Bunty9/ssr4/docs/images/ssr4-bottom-web.jpg

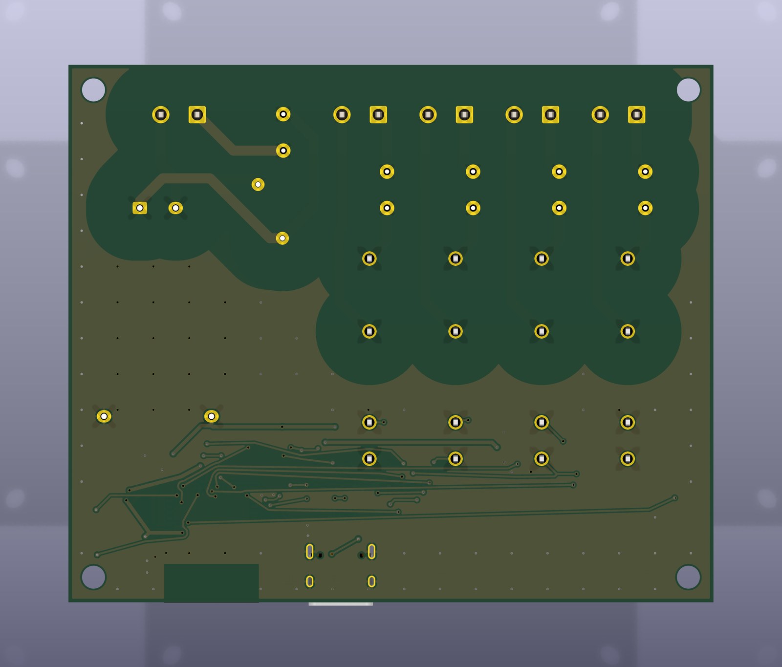
docs/images/ssr4-bottom-web.jpg
