Bunty9/ssr4/docs/images/ssr4-low-angle-web.jpg

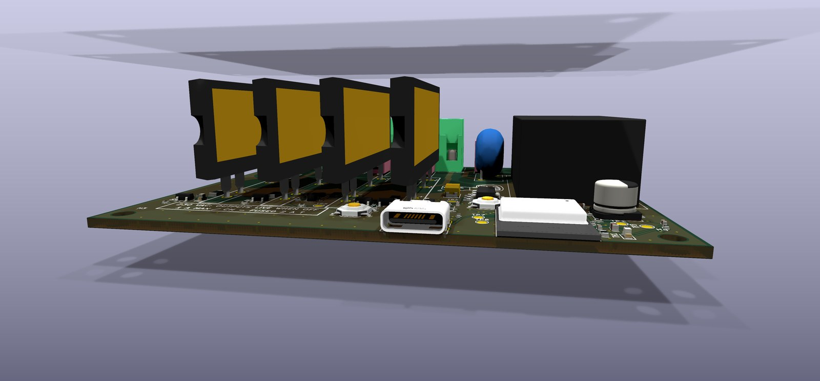
docs/images/ssr4-low-angle-web.jpg
