Bunty9/ssr4/hardware/fabrication/jlcpcb/bom.csv

Comment | Designator | Footprint | LCSC Part #
220u | C1 | CP_Elec_6.3x5.4 | C2977551
10u | C2,C4 | C_0603_1608Metric | C96446
22u | C3 | CP_EIA-3528-21_Kemet-B | C122226
100n | C5,C7,C8 | C_0402_1005Metric | C1525
1u | C6 | C_0402_1005Metric | C52923
D_Schottky | D1 | D_SOD-123 | C8598
LED | D3,D4,D5,D6,D7 | LED_0603_1608Metric | C2986060
Fuse | F1 | Fuse_Littelfuse_395Series | C99566
Fuse | F2,F3,F4,F5 | Fuse_Littelfuse_395Series | C142678
USB_C_Receptacle_USB2.0_16P | J1 | USB_C_Receptacle_HRO_TYPE-C-31-M-12 | C165948
CPC40055ST | K1,K2,K3,K4 | SIP-4_L38.1-W3.8_CPC40055ST | C1527353
HLK-PM01 | PS1 | Converter_ACDC_Hi-Link_HLK-PMxx | C209903
AO3400A | Q1,Q2,Q3,Q4,Q5 | SOT-23 | C20917
10k | R1,R2,R3,R4,R9,R11 | R_0402_1005Metric | C25744
22 | R5,R6 | R_0402_1005Metric | C25092
5.1k | R7,R8 | R_0402_1005Metric | C25905
220 | R10 | R_0402_1005Metric | C25091
2k | R12,R14,R15,R17,R18,R20,R21,R23,R24 | R_0402_1005Metric | C4109
220 | R13,R16,R19,R22 | R_1206_3216Metric | C17957
Varistor | RV1 | RV_Disc_D12mm_W6.7mm_P7.5mm | C2839517
SW_Push | SW1,SW2 | SW_Push_1P1T_XKB_TS-1187A | C318884
10k | TH1 | R_0603_1608Metric | C279936
ESP32-C3-MINI-1-H4X | U1 | WIFIM-SMD_ESP32-C3-MINI-1 | C41349510
AMS1117-3.3 | U2 | SOT-223-3_TabPin2 | C6186
USBLC6-2SC6 | U3 | SOT-23-6 | C7519
TMP302ADRLR | U7 | SOT-563_TI_DRL0006A | C2877557
Screw_Terminal_01x02 | X1,X2,X3,X4,X5 | TerminalBlock_CUI_TB007-508-02_1x02_P5.08mm_Horizontal | C8465
