Bunty9/ssr4/hardware/mechanical/ssr4-assembly.step

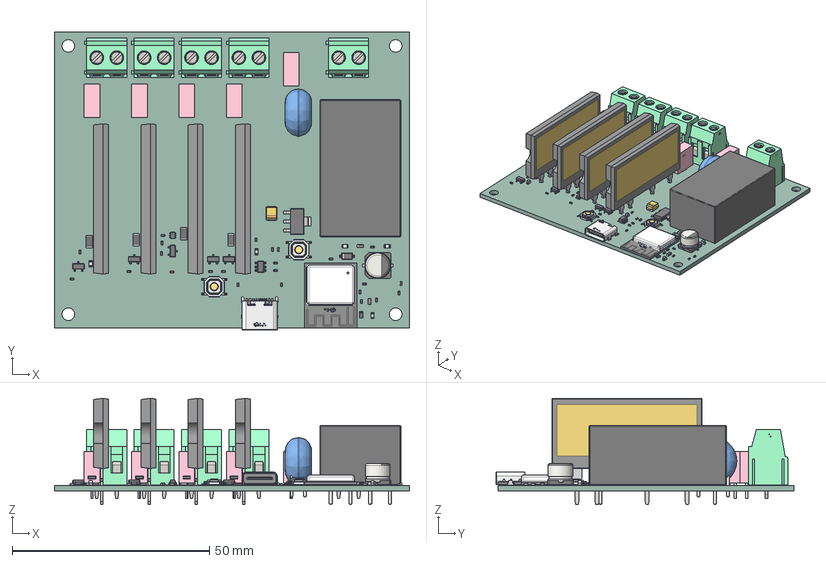
[picture p8: CAD file, 2026-10-29]
hardware/mechanical/ssr4-assembly.step
90.0 x 75.5 x 26.9 mm
FUSE-TH_L8.5-W4.0-H8.5-P5.08 x 5
D_SOD-123
SW-SMD_4P-L5.1-W5.1-P3.70-LS6.5-TL_H1.5 x 2
LED_0603_1608Metric x 5
CP_Elec_63x54
SOT-223
CONN-TH_2P-P5.00_WJ500V-5.08-2P x 5
R_1206_3216Metric x 4
R_0402_1005Metric x 20
WIFIM-SMD_ESP32-C3-MINI-1
SIP-4_L38.1-W3.8_CPC40055ST x 4
C_0402_1005Metric x 4
R_0603_1608Metric
SOT-23 x 5
C_0603_1608Metric x 2
SOT-23-6
CP_EIA_3528_21_Kemet_B
RV_Disc_D12mm_W67mm_P75mm
SOT_563
Converter_ACDC_Hi-Link_HLK-PMxx
USB-C_SMD-TYPE-C-31-M-12
circuit_PCB
