Bunty9/ssr4/hardware/mechanical/ssr4-outline.dxf

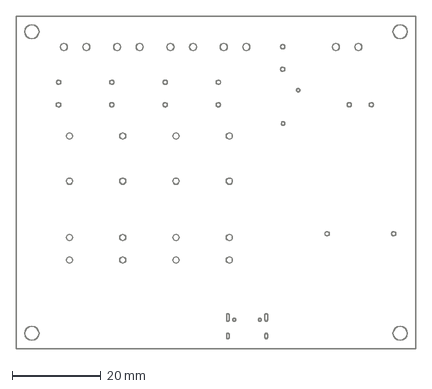
[picture p9: CAD file, 2026-10-29]
hardware/mechanical/ssr4-outline.dxf
90.0 x 75.0 mm
