Bunty9/ssr4/hardware/mechanical/ssr4-board-only.step

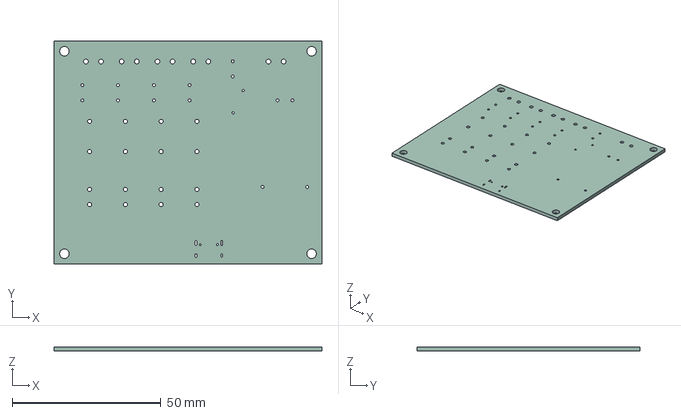
[picture p10: CAD file, 2026-10-29]
hardware/mechanical/ssr4-board-only.step
90.0 x 75.0 x 1.51 mm
