Bunty9/ssr4/validation/ntc-table.md

<!-- generated by `pcb publish` from blocks/calc.py -->
| Board temperature (°C) | NTC (kΩ) | IO0 voltage (V) | Slope (mV/°C) | ±35 mV ADC error as °C |
|---:|---:|---:|---:|---:|
| -20 | 105.38 | 3.014 | -16.1 | ±2.2 |
| 0 | 33.62 | 2.543 | -30.9 | ±1.1 |
| 1.4 | 31.23 | 2.500 | -31.8 | ±1.1 |
| 25 | 10.00 | 1.650 | -36.7 | ±1.0 |
| 45 | 4.35 | 1.000 | -27.2 | ±1.3 |
| 50 | 3.59 | 0.871 | -24.3 | ±1.4 |
| 55 | 2.98 | 0.757 | -21.4 | ±1.6 |
| 60 | 2.49 | 0.657 | -18.7 | ±1.9 |
| 80 | 1.27 | 0.372 | -10.5 | ±3.3 |
| 110 | 0.53 | 0.166 | -4.2 | ±8.3 |
