Bunty9/ssr4/hardware/ssr4-schematic.pdf

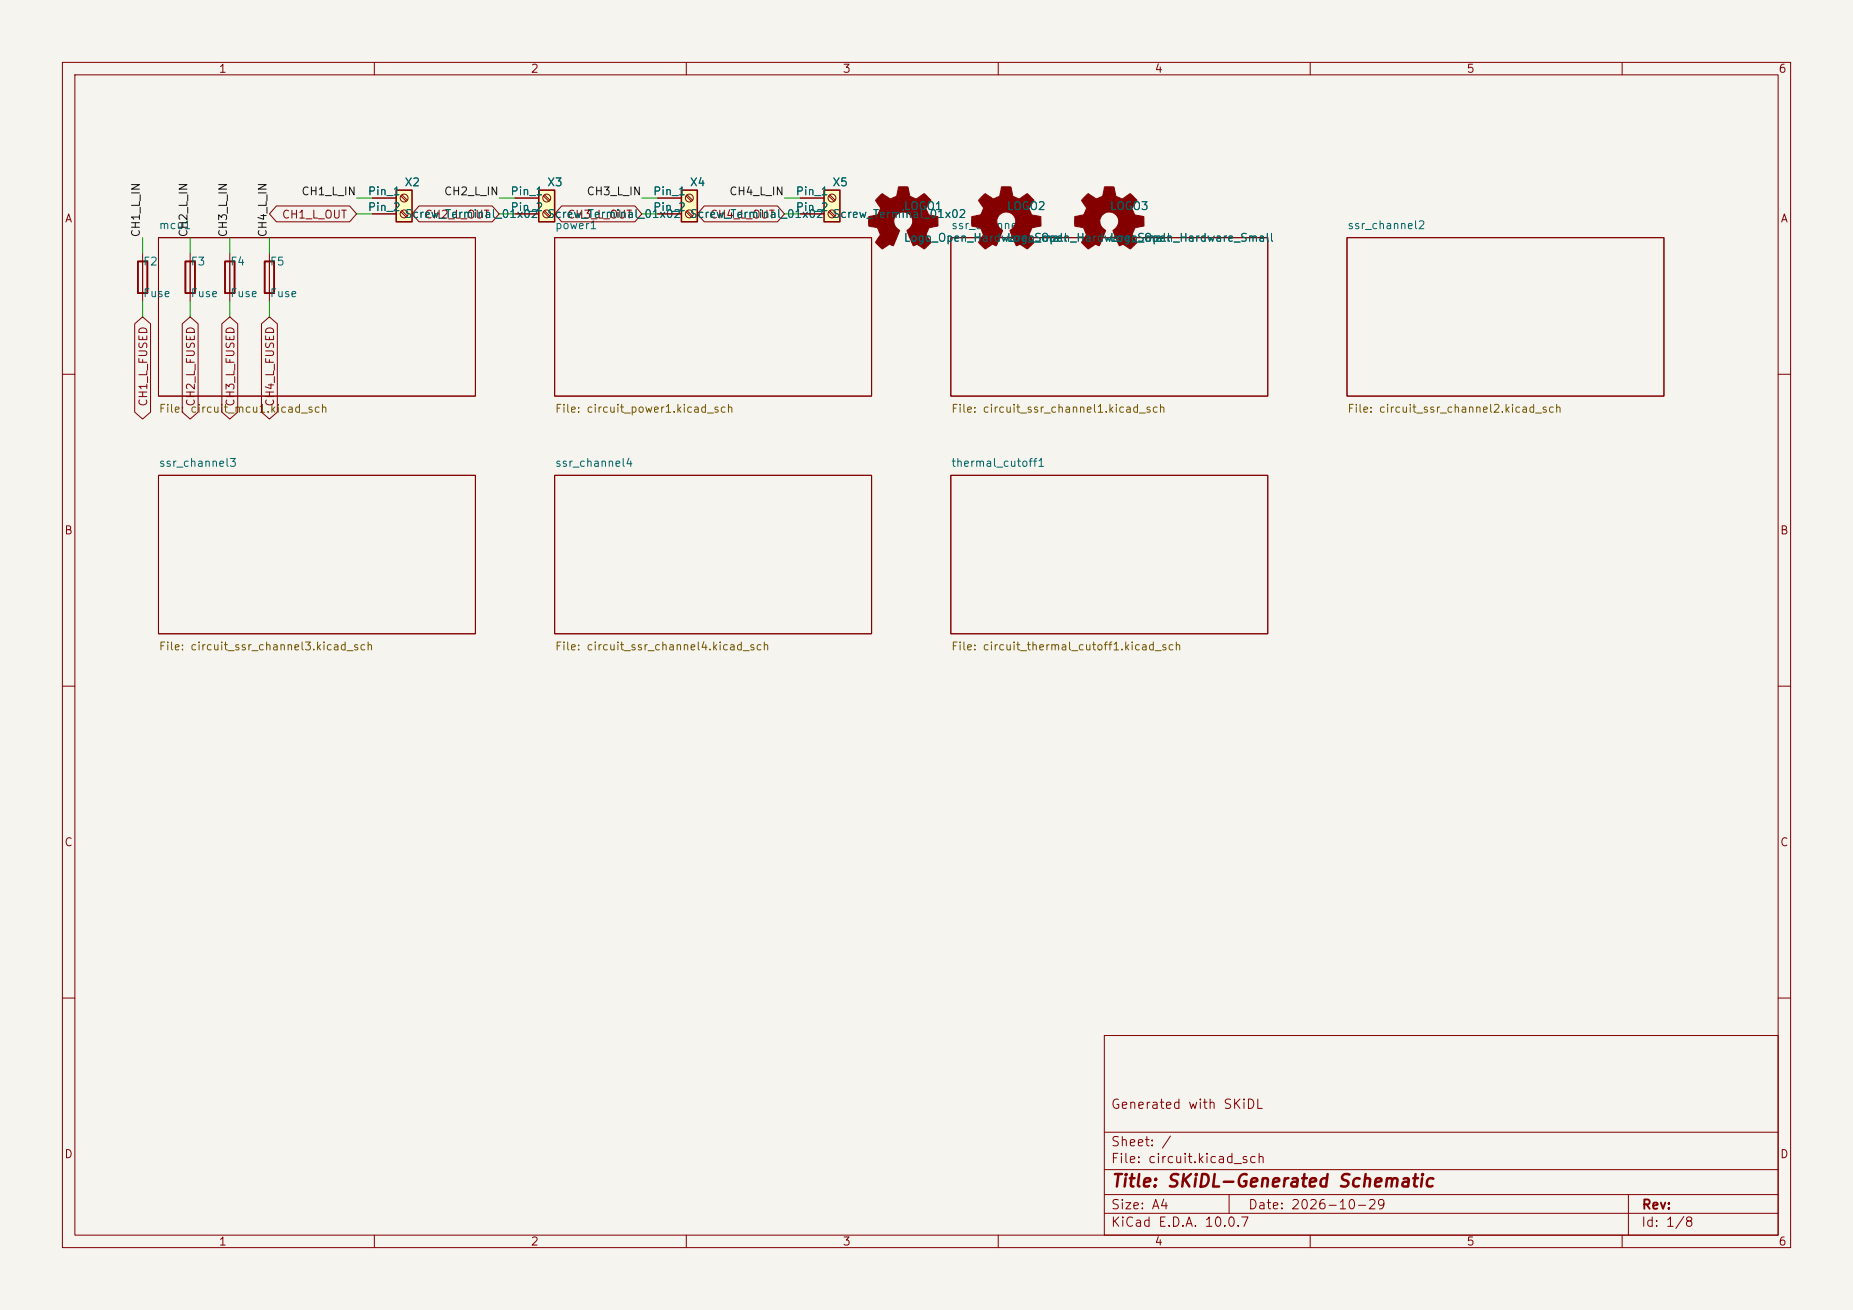
[picture p11: page 1]

Sheet: /
File: circuit.kicad_sch
Title: SKiDL-Generated Schematic

Size: A4 | Rev:
KiCad E.D.A. 10.0.7 | Id: 1/8

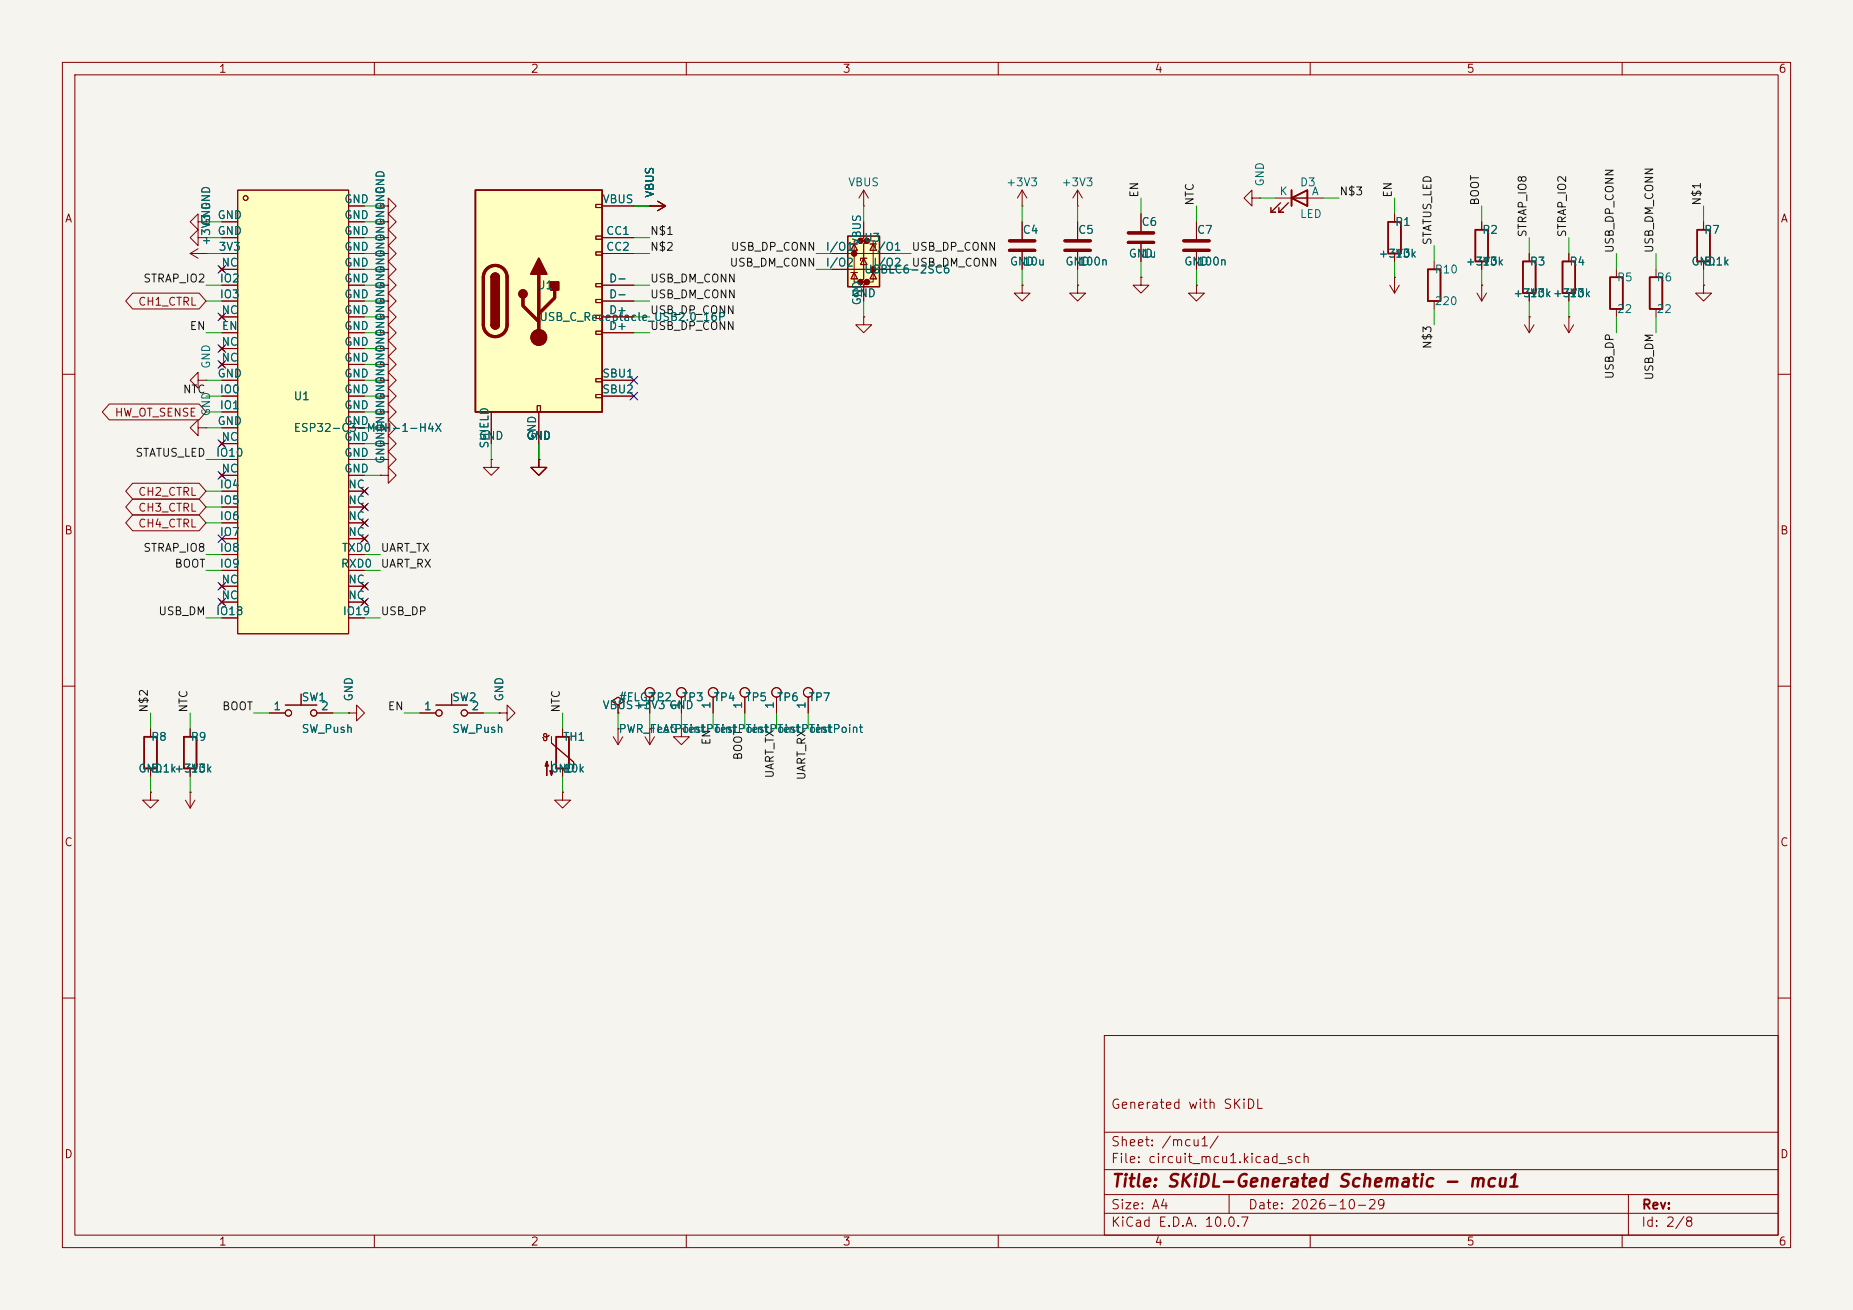
[picture p12: page 2]

NCNC
Generated with SKiDL GND GND

Sheet: /mcu1/
File: circuit_mcu1.kicad_sch
Title: SKiDL-Generated Schematic - mcu1

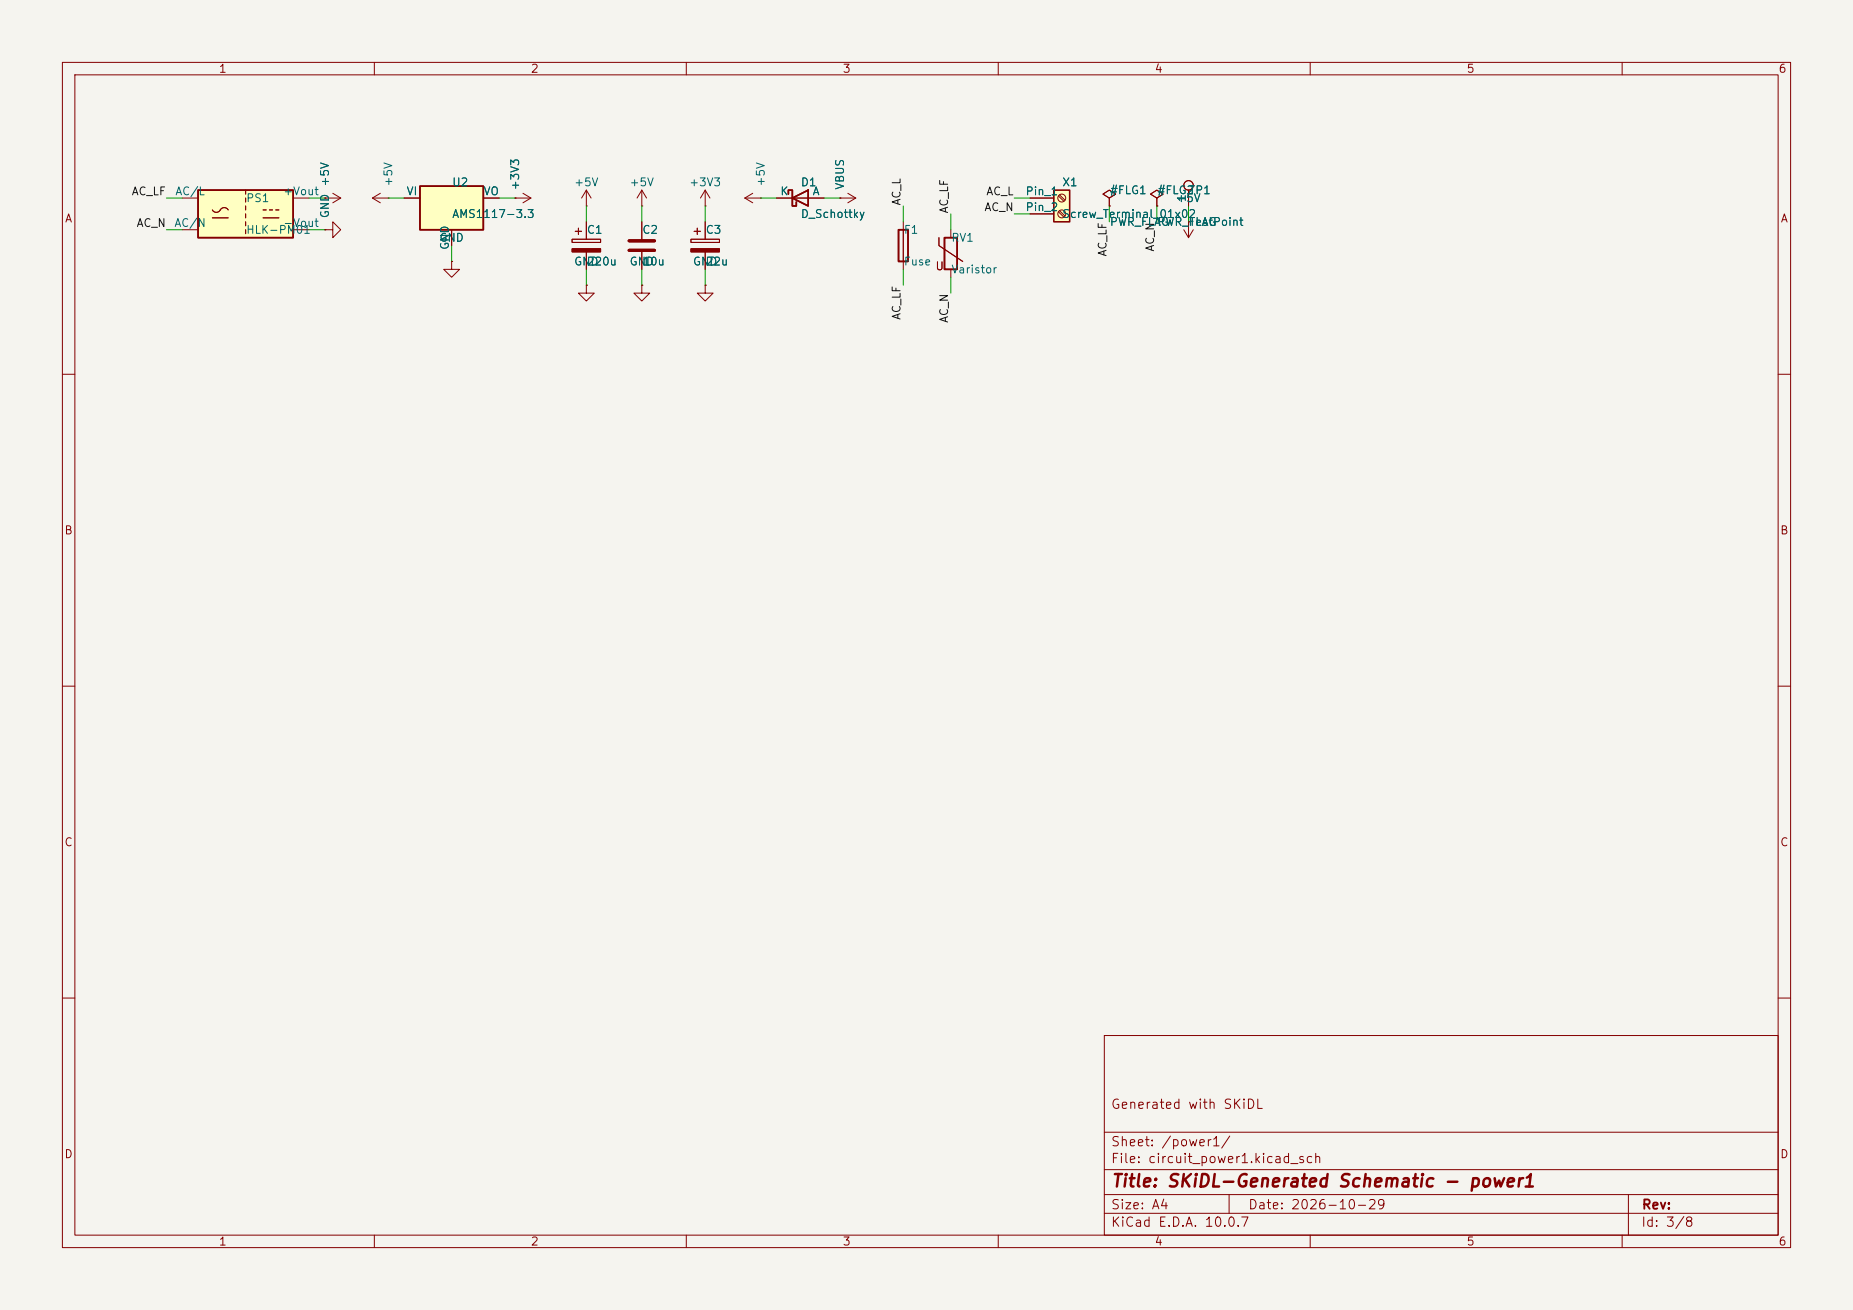
[picture p13: page 3]

Sheet: /power1/
File: circuit_power1.kicad_sch
Title: SKiDL-Generated Schematic - power1

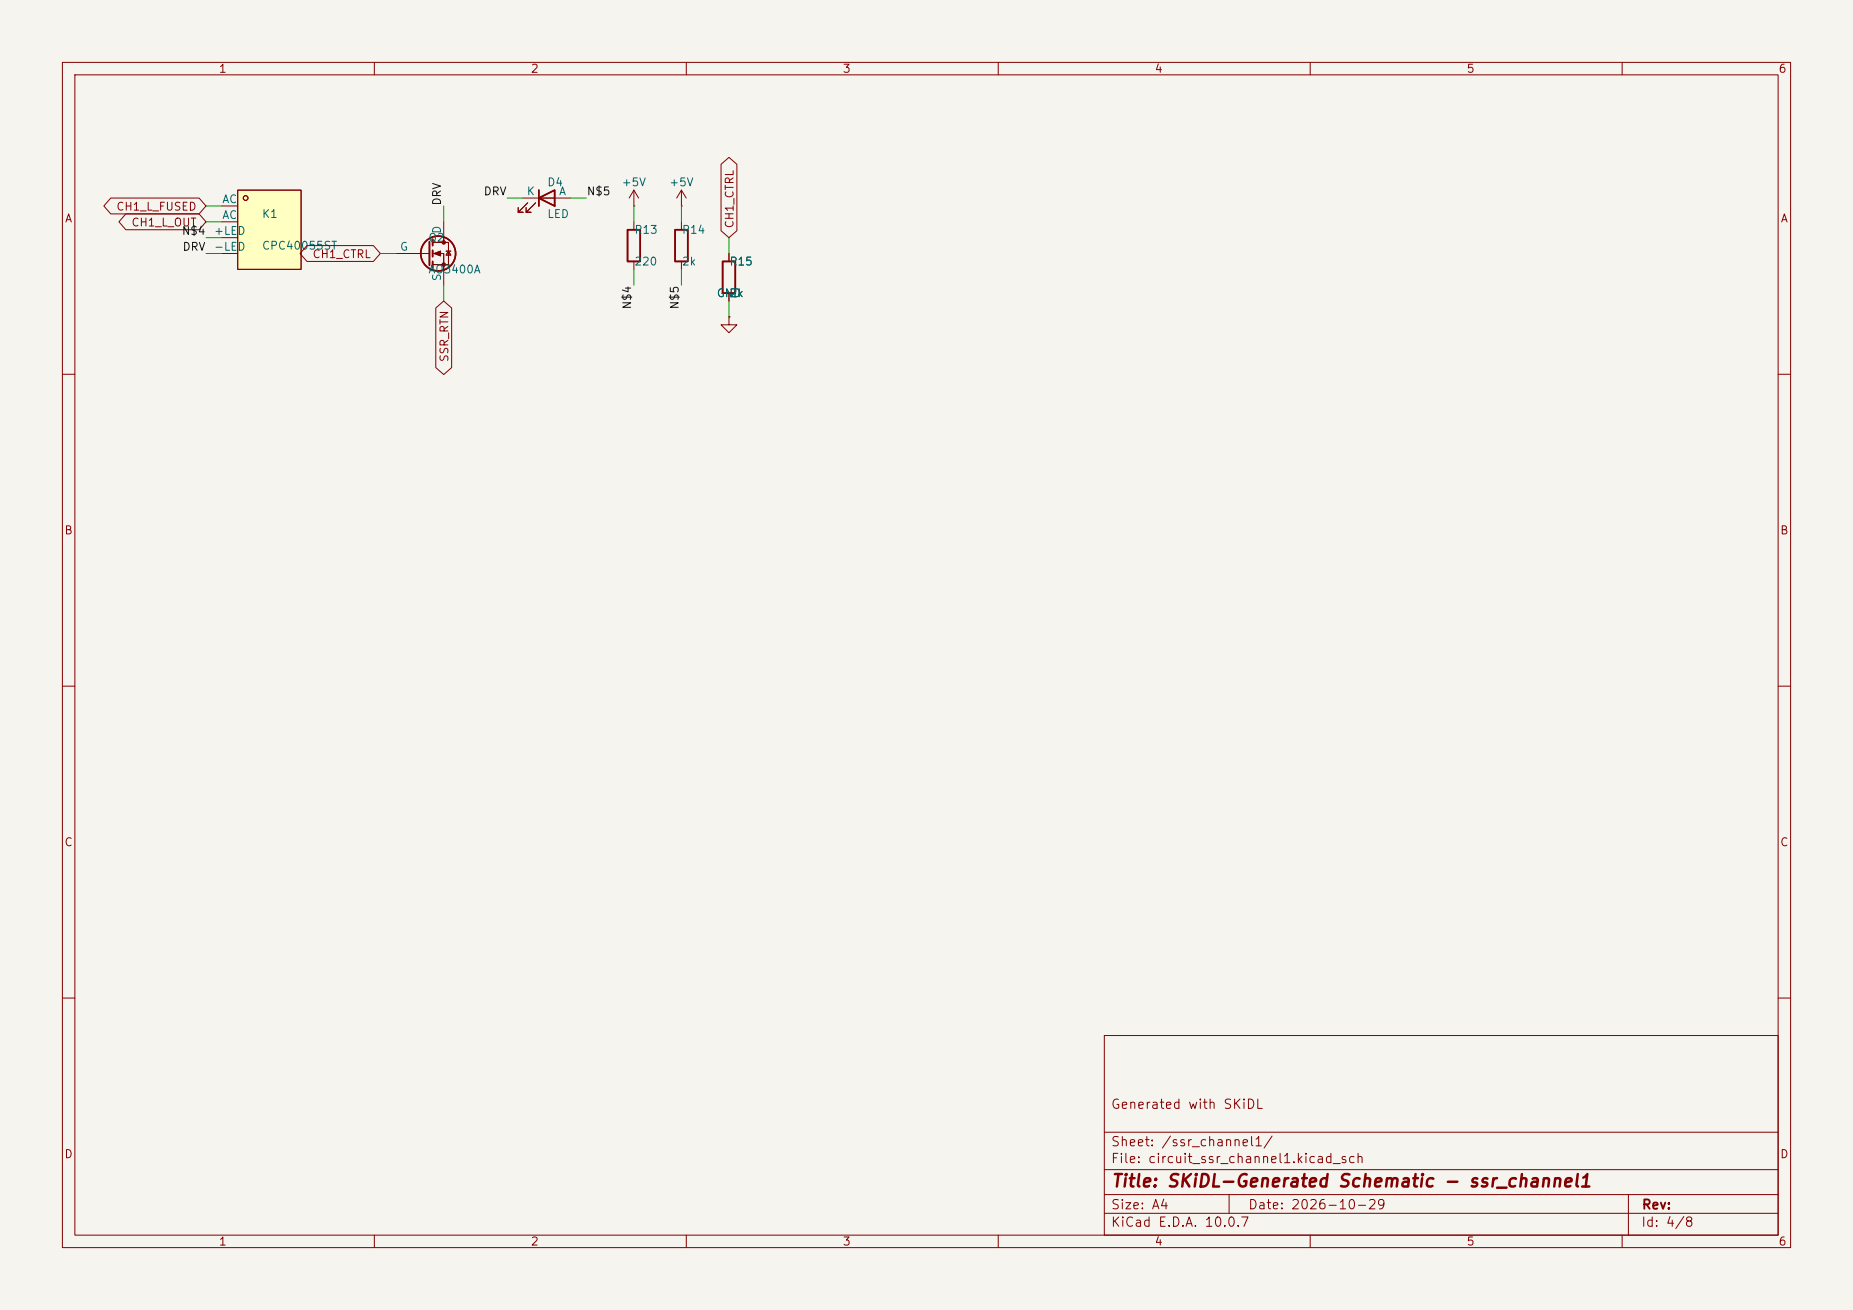
[picture p14: page 4]

Sheet: /ssr_channel1/
File: circuit_ssr_channel1.kicad_sch
Title: SKiDL-Generated Schematic - ssr_channel1

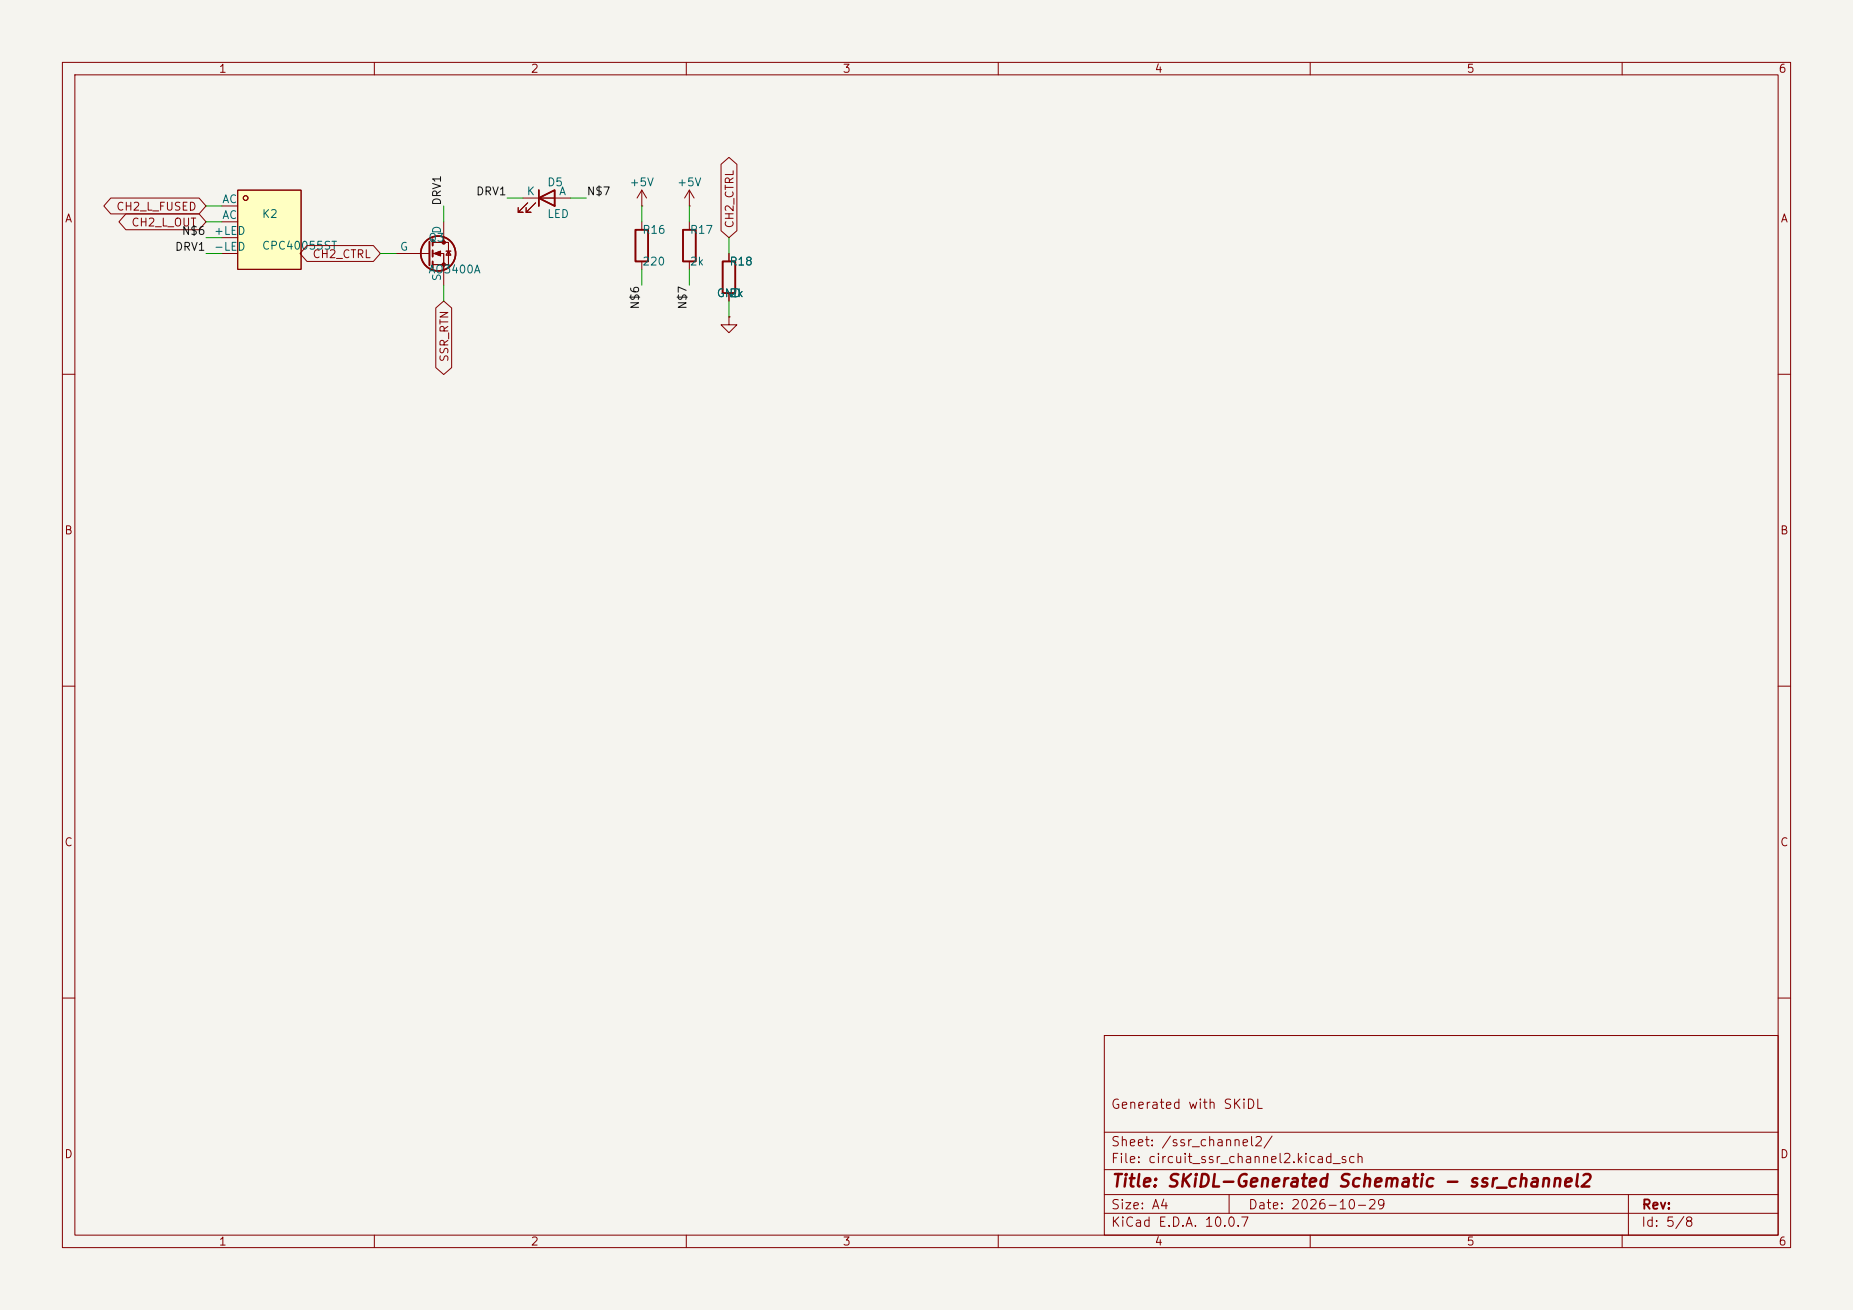
[picture p15: page 5]

Sheet: /ssr_channel2/
File: circuit_ssr_channel2.kicad_sch
Title: SKiDL-Generated Schematic - ssr_channel2

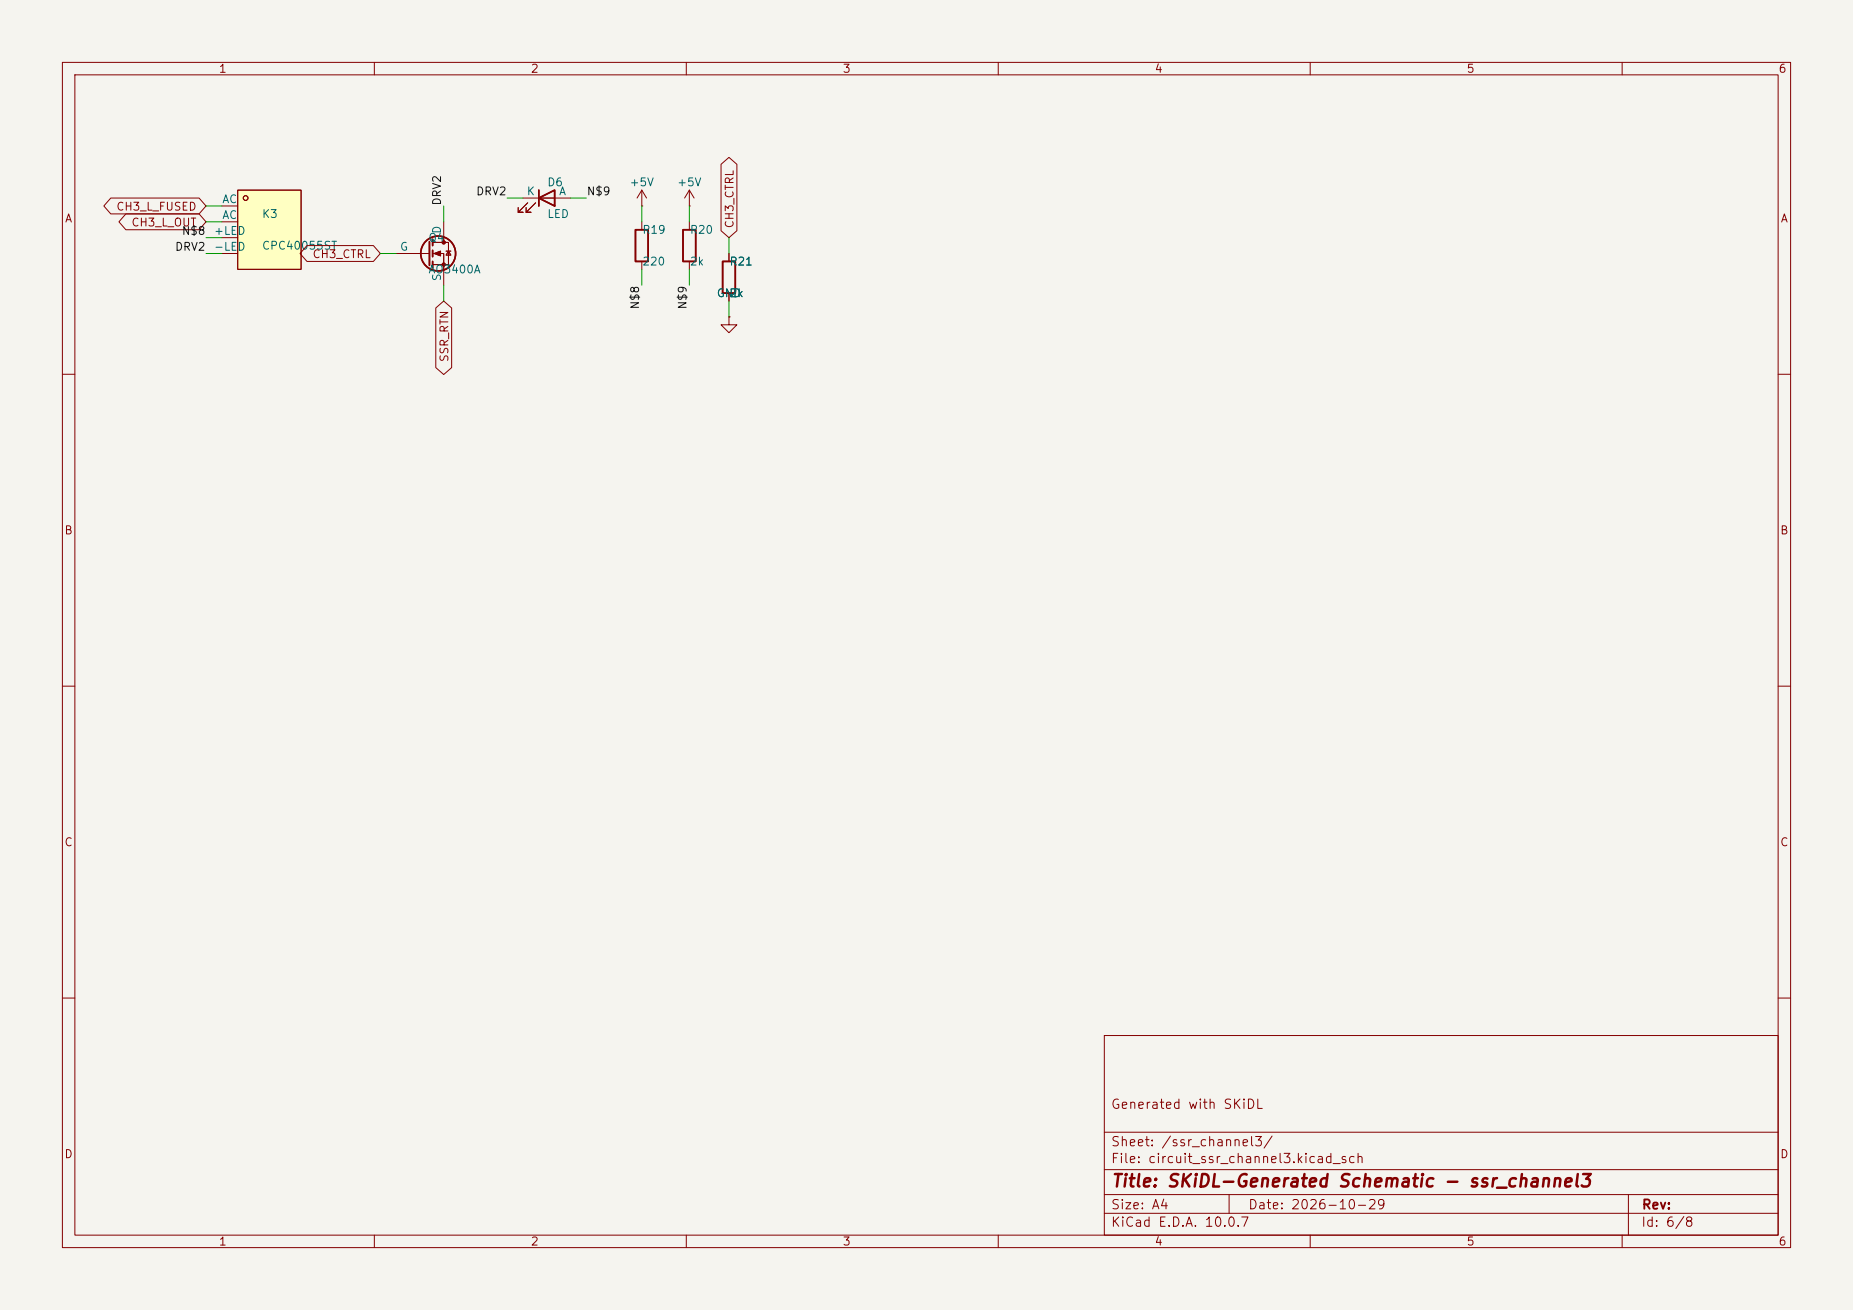
[picture p16: page 6]

Sheet: /ssr_channel3/
File: circuit_ssr_channel3.kicad_sch
Title: SKiDL-Generated Schematic - ssr_channel3

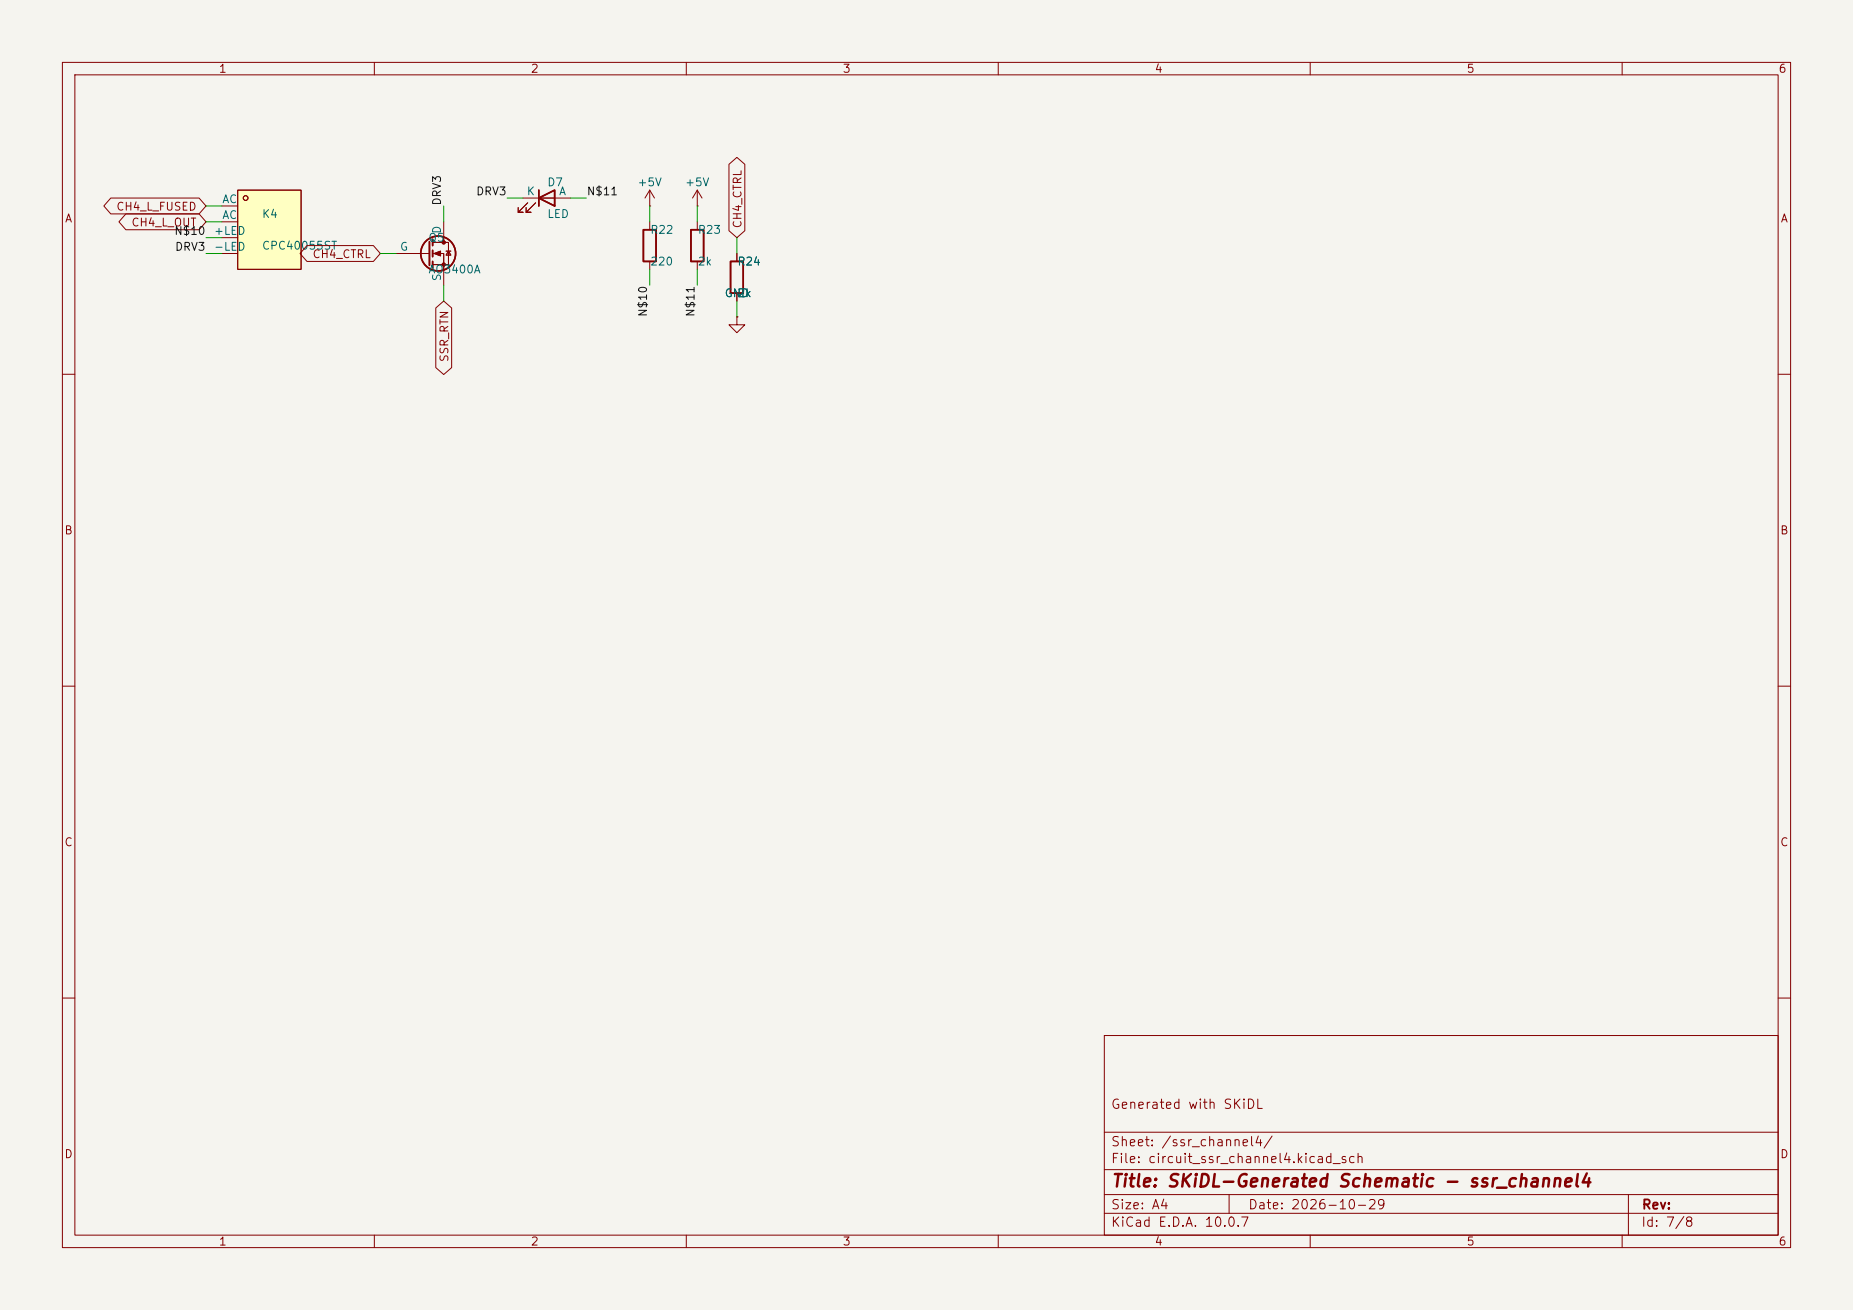
[picture p17: page 7]

Sheet: /ssr_channel4/
File: circuit_ssr_channel4.kicad_sch
Title: SKiDL-Generated Schematic - ssr_channel4

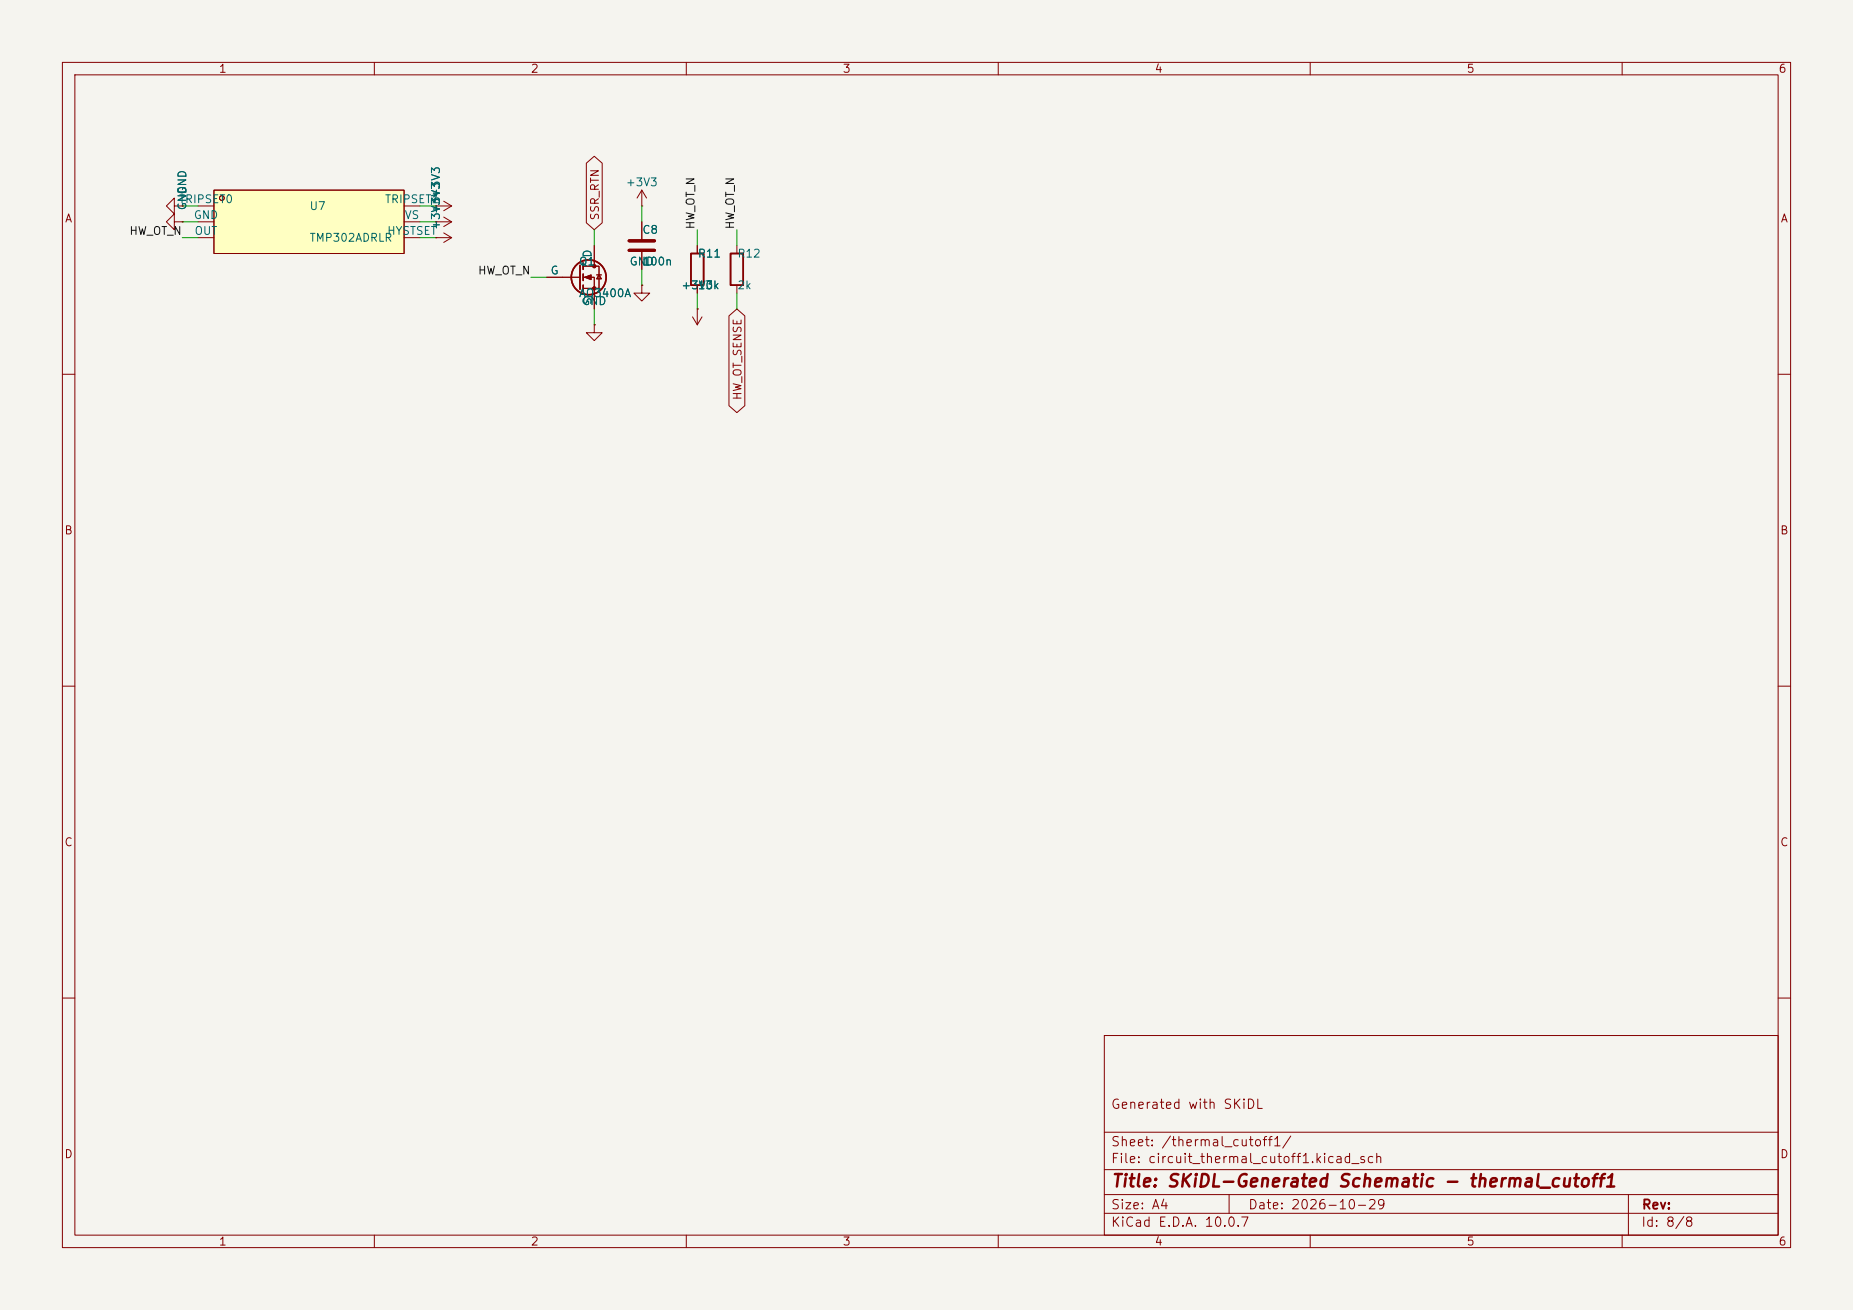
[picture p18: page 8]

Sheet: /thermal_cutoff1/
File: circuit_thermal_cutoff1.kicad_sch
Title: SKiDL-Generated Schematic - thermal_cutoff1
