Bunty9/ssr4/hardware/kicad/ssr4/circuit.kicad_pcb

## KiCad design hardware/kicad/ssr4/circuit.kicad_pcb (2026-10-29)

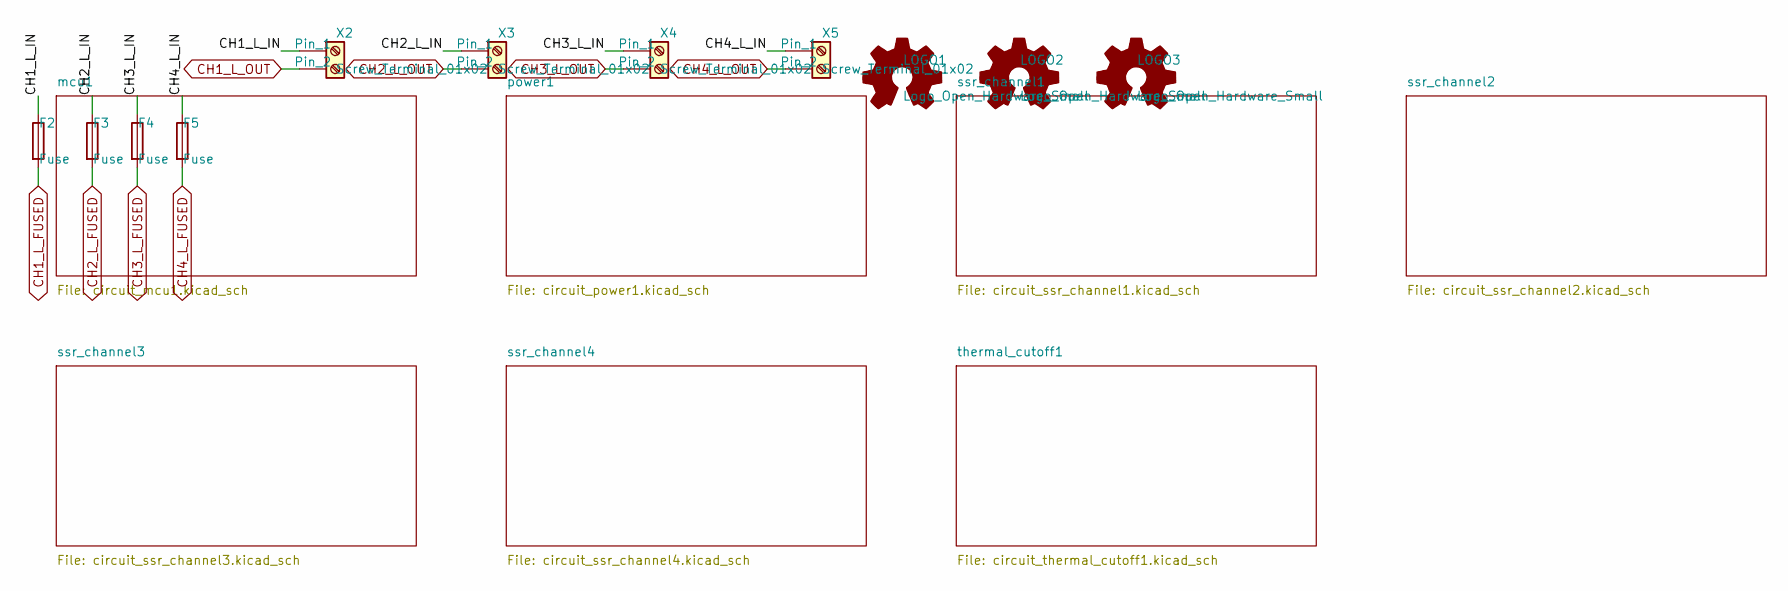
[picture p23: schematic circuit.kicad_sch, SKiDL-Generated Schematic]

Parts:
F2, F3, F4, F5: Fuse; Fuse_Littelfuse_395Series; MPN 39212000000; LCSC C142678
LOGO1: Logo_Open_Hardware_Small; Label_MainsWarning; MPN UNSET-MPN
LOGO2: Logo_Open_Hardware_Small; Doodle_Scouter; MPN UNSET-MPN
LOGO3: Logo_Open_Hardware_Small; Label_Terminals; MPN UNSET-MPN
X2, X3, X4, X5: Screw_Terminal_01x02; TerminalBlock_CUI_TB007-508-02_1x02_P5.08mm_Horizontal; MPN WJ500V-5.08-2P; LCSC C8465

Connections:
/CH1_L_IN: F2.1, X2.1
/CH2_L_IN: F3.1, X3.1
/CH3_L_IN: F4.1, X4.1
/CH4_L_IN: F5.1, X5.1
CH1_L_FUSED: F2.2; also elsewhere on the board
CH1_L_OUT: X2.2; also elsewhere on the board
CH2_L_FUSED: F3.2; also elsewhere on the board
CH2_L_OUT: X3.2; also elsewhere on the board
CH3_L_FUSED: F4.2; also elsewhere on the board
CH3_L_OUT: X4.2; also elsewhere on the board
CH4_L_FUSED: F5.2; also elsewhere on the board
CH4_L_OUT: X5.2; also elsewhere on the board

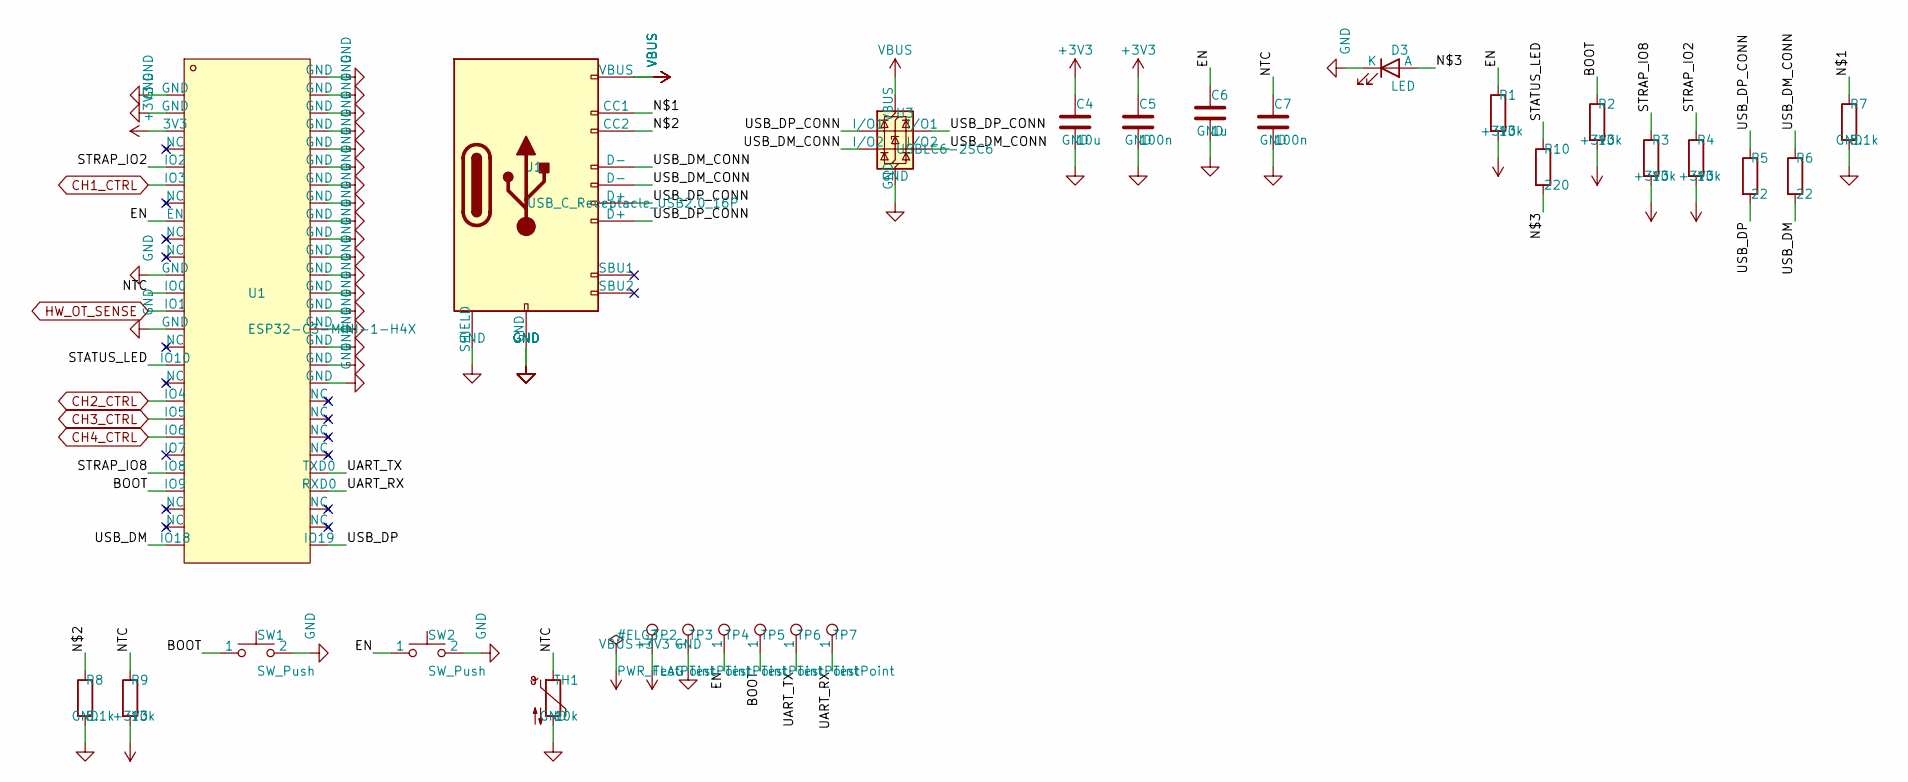
[picture p24: schematic circuit_mcu1.kicad_sch, SKiDL-Generated Schematic - mcu1]

Parts:
C4: 10u; C_0603_1608Metric; MPN CL10A106MA8NRNC; LCSC C96446
C5, C7: 100n; C_0402_1005Metric; MPN CL05B104KO5NNNC; LCSC C1525
C6: 1u; C_0402_1005Metric; MPN CL05A105KA5NQNC; LCSC C52923
D3: LED; LED_0603_1608Metric; MPN 19-217/R6C-AL1M2VY/6T; LCSC C2986060
J1: USB_C_Receptacle_USB2.0_16P; USB_C_Receptacle_HRO_TYPE-C-31-M-12; MPN TYPE-C-31-M-12; LCSC C165948
R1, R2, R3, R4, R9: 10k; R_0402_1005Metric; MPN 0402WGF1002TCE; LCSC C25744
R5, R6: 22; R_0402_1005Metric; MPN 0402WGF220JTCE; LCSC C25092
R7, R8: 5.1k; R_0402_1005Metric; MPN 0402WGF5101TCE; LCSC C25905
R10: 220; R_0402_1005Metric; MPN 0402WGF2200TCE; LCSC C25091
SW1, SW2: SW_Push; SW_Push_1P1T_XKB_TS-1187A; MPN TS-1187A-B-A-B; LCSC C318884
TH1: 10k; R_0603_1608Metric; MPN SDNT1608X103F3950FTF; LCSC C279936
TP2, TP3, TP4, TP5, TP6, TP7: TestPoint; TestPoint_Pad_D1.5mm; MPN UNSET-MPN
U1: ESP32-C3-MINI-1-H4X; WIFIM-SMD_ESP32-C3-MINI-1; MPN ESP32-C3-MINI-1-H4X; LCSC C41349510
U3: USBLC6-2SC6; SOT-23-6; MPN USBLC6-2SC6; LCSC C7519

Connections:
+3V3: C4.1, C5.1, R1.2, R2.2, R3.2, R4.2, R9.2, TP2.1, U1.3 (3V3); also elsewhere on the board
/mcu1/BOOT: R2.1, SW1.1, TP5.1, U1.23 (IO9)
/mcu1/EN: C6.1, R1.1, SW2.1, TP4.1, U1.8 (EN)
/mcu1/N$1: J1.A5 (CC1), R7.1
/mcu1/N$2: J1.B5 (CC2), R8.1
/mcu1/N$3: D3.2 (A), R10.2
/mcu1/NTC: C7.1, R9.1, TH1.1, U1.12 (IO0)
/mcu1/STATUS_LED: R10.1, U1.16 (IO10)
/mcu1/STRAP_IO2: R4.1, U1.5 (IO2)
/mcu1/STRAP_IO8: R3.1, U1.22 (IO8)
/mcu1/UART_RX: TP7.1, U1.30 (RXD0)
/mcu1/UART_TX: TP6.1, U1.31 (TXD0)
/mcu1/USB_DM: R6.2, U1.26 (IO18)
/mcu1/USB_DM_CONN: J1.A7 (D-), J1.B7 (D-), R6.1, U3.3 (I/O2), U3.4 (I/O2)
/mcu1/USB_DP: R5.2, U1.27 (IO19)
/mcu1/USB_DP_CONN: J1.A6 (D+), J1.B6 (D+), R5.1, U3.1 (I/O1), U3.6 (I/O1)
CH1_CTRL: U1.6 (IO3); also elsewhere on the board
CH2_CTRL: U1.18 (IO4); also elsewhere on the board
CH3_CTRL: U1.19 (IO5); also elsewhere on the board
CH4_CTRL: U1.20 (IO6); also elsewhere on the board
GND: C4.2, C5.2, C6.2, C7.2, D3.1 (K), J1.A1 (GND), J1.A12 (GND), J1.B1 (GND), J1.B12 (GND), J1.SH (SHIELD), R7.2, R8.2, SW1.2, SW2.2, TH1.2, TP3.1, U1.1 (GND), U1.2 (GND), U1.11 (GND), U1.14 (GND), U1.36 (GND), U1.37 (GND), U1.38 (GND), U1.39 (GND), U1.40 (GND), U1.41 (GND), U1.42 (GND), U1.43 (GND), U1.44 (GND), U1.45 (GND), U1.46 (GND), U1.47 (GND), U1.48 (GND), U1.49 (GND), U1.50 (GND), U1.51 (GND), U1.52 (GND), U1.53 (GND), U3.2 (GND); also elsewhere on the board
HW_OT_SENSE: U1.13 (IO1); also elsewhere on the board
VBUS: J1.A4 (VBUS), J1.A9 (VBUS), J1.B4 (VBUS), J1.B9 (VBUS), U3.5 (VBUS); also elsewhere on the board

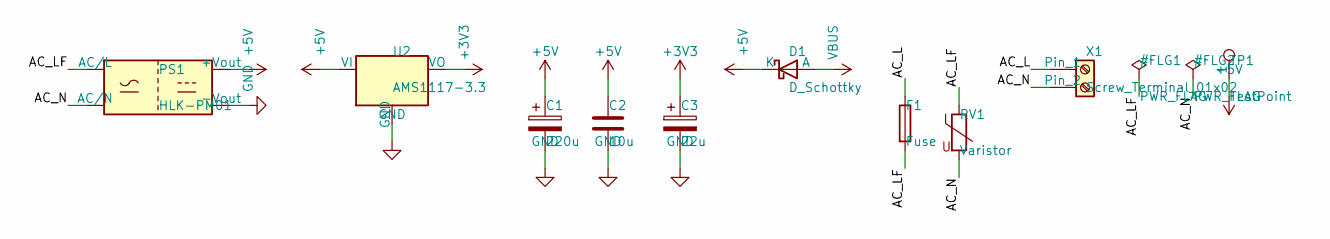
[picture p25: schematic circuit_power1.kicad_sch, SKiDL-Generated Schematic - power1]

Parts:
C1: 220u; CP_Elec_6.3x5.4; MPN RVT1C221M0605; LCSC C2977551
C2: 10u; C_0603_1608Metric; MPN CL10A106MA8NRNC; LCSC C96446
C3: 22u; CP_EIA-3528-21_Kemet-B; MPN CA45-B016K226T; LCSC C122226
D1: D_Schottky; D_SOD-123; MPN B5819W SL; LCSC C8598
F1: Fuse; Fuse_Littelfuse_395Series; MPN 39211000000; LCSC C99566
PS1: HLK-PM01; Converter_ACDC_Hi-Link_HLK-PMxx; MPN HLK-PM01; LCSC C209903
RV1: Varistor; RV_Disc_D12mm_W6.7mm_P7.5mm; MPN 10D561K; LCSC C2839517
TP1: TestPoint; TestPoint_Pad_D1.5mm; MPN UNSET-MPN
U2: AMS1117-3.3; SOT-223-3_TabPin2; MPN AMS1117-3.3; LCSC C6186
X1: Screw_Terminal_01x02; TerminalBlock_CUI_TB007-508-02_1x02_P5.08mm_Horizontal; MPN WJ500V-5.08-2P; LCSC C8465

Connections:
+3V3: C3.1, U2.2 (VO); also elsewhere on the board
+5V: C1.1, C2.1, D1.1 (K), PS1.4 (+Vout), TP1.1, U2.3 (VI); also elsewhere on the board
/power1/AC_L: F1.1, X1.1
/power1/AC_LF: F1.2, PS1.1 (AC/L), RV1.1
/power1/AC_N: PS1.2 (AC/N), RV1.2, X1.2
GND: C1.2, C2.2, C3.2, PS1.3 (-Vout), U2.1 (GND); also elsewhere on the board
VBUS: D1.2 (A); also elsewhere on the board

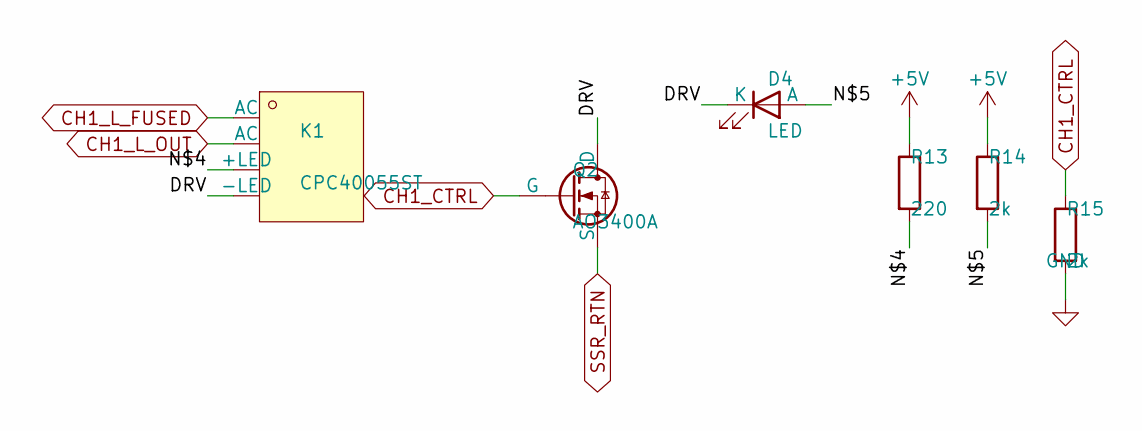
[picture p26: schematic circuit_ssr_channel1.kicad_sch, SKiDL-Generated Schematic - ssr_channel1]

Parts:
D4: LED; LED_0603_1608Metric; MPN 19-217/R6C-AL1M2VY/6T; LCSC C2986060
K1: CPC40055ST; SIP-4_L38.1-W3.8_CPC40055ST; MPN CPC40055ST; LCSC C1527353
Q2: AO3400A; SOT-23; MPN AO3400A; LCSC C20917
R13: 220; R_1206_3216Metric; MPN 1206W4F2200T5E; LCSC C17957
R14, R15: 2k; R_0402_1005Metric; MPN 0402WGF2001TCE; LCSC C4109

Connections:
+5V: R13.1, R14.1; also elsewhere on the board
/ssr_channel1/DRV: D4.1 (K), K1.4 (-LED), Q2.3 (D)
/ssr_channel1/N$4: K1.3 (+LED), R13.2
/ssr_channel1/N$5: D4.2 (A), R14.2
CH1_CTRL: Q2.1 (G), R15.1; also elsewhere on the board
CH1_L_FUSED: K1.1 (AC); also elsewhere on the board
CH1_L_OUT: K1.2 (AC); also elsewhere on the board
GND: R15.2; also elsewhere on the board
SSR_RTN: Q2.2 (S); also elsewhere on the board

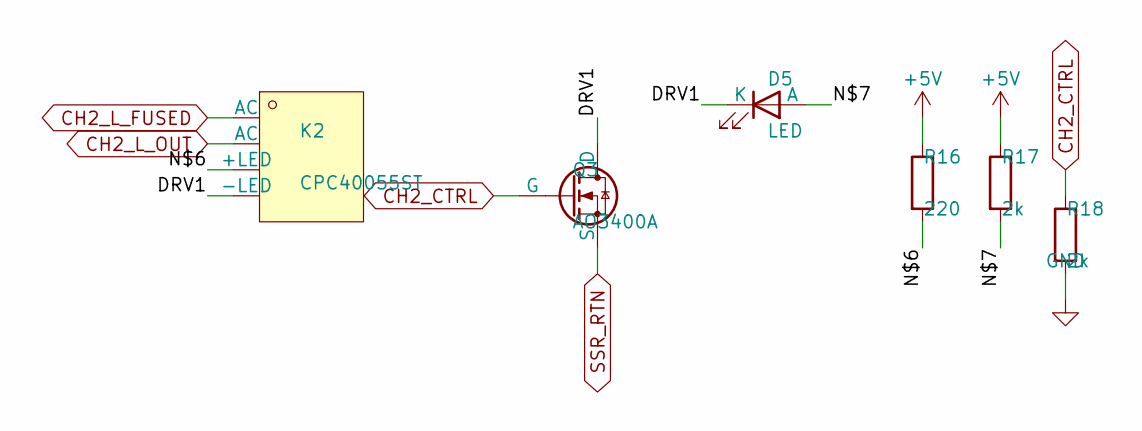
[picture p27: schematic circuit_ssr_channel2.kicad_sch, SKiDL-Generated Schematic - ssr_channel2]

Parts:
D5: LED; LED_0603_1608Metric; MPN 19-217/R6C-AL1M2VY/6T; LCSC C2986060
K2: CPC40055ST; SIP-4_L38.1-W3.8_CPC40055ST; MPN CPC40055ST; LCSC C1527353
Q3: AO3400A; SOT-23; MPN AO3400A; LCSC C20917
R16: 220; R_1206_3216Metric; MPN 1206W4F2200T5E; LCSC C17957
R17, R18: 2k; R_0402_1005Metric; MPN 0402WGF2001TCE; LCSC C4109

Connections:
+5V: R16.1, R17.1; also elsewhere on the board
/ssr_channel2/DRV1: D5.1 (K), K2.4 (-LED), Q3.3 (D)
/ssr_channel2/N$6: K2.3 (+LED), R16.2
/ssr_channel2/N$7: D5.2 (A), R17.2
CH2_CTRL: Q3.1 (G), R18.1; also elsewhere on the board
CH2_L_FUSED: K2.1 (AC); also elsewhere on the board
CH2_L_OUT: K2.2 (AC); also elsewhere on the board
GND: R18.2; also elsewhere on the board
SSR_RTN: Q3.2 (S); also elsewhere on the board

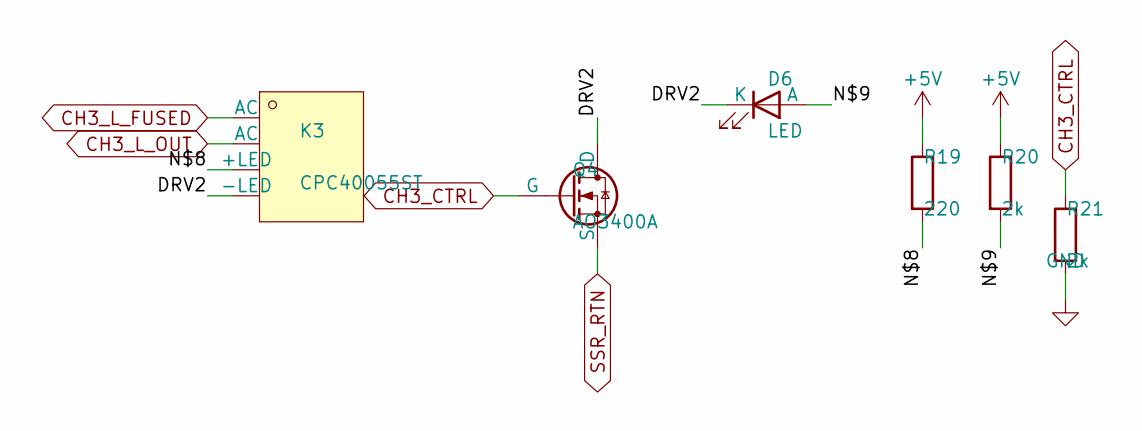
[picture p28: schematic circuit_ssr_channel3.kicad_sch, SKiDL-Generated Schematic - ssr_channel3]

Parts:
D6: LED; LED_0603_1608Metric; MPN 19-217/R6C-AL1M2VY/6T; LCSC C2986060
K3: CPC40055ST; SIP-4_L38.1-W3.8_CPC40055ST; MPN CPC40055ST; LCSC C1527353
Q4: AO3400A; SOT-23; MPN AO3400A; LCSC C20917
R19: 220; R_1206_3216Metric; MPN 1206W4F2200T5E; LCSC C17957
R20, R21: 2k; R_0402_1005Metric; MPN 0402WGF2001TCE; LCSC C4109

Connections:
+5V: R19.1, R20.1; also elsewhere on the board
/ssr_channel3/DRV2: D6.1 (K), K3.4 (-LED), Q4.3 (D)
/ssr_channel3/N$8: K3.3 (+LED), R19.2
/ssr_channel3/N$9: D6.2 (A), R20.2
CH3_CTRL: Q4.1 (G), R21.1; also elsewhere on the board
CH3_L_FUSED: K3.1 (AC); also elsewhere on the board
CH3_L_OUT: K3.2 (AC); also elsewhere on the board
GND: R21.2; also elsewhere on the board
SSR_RTN: Q4.2 (S); also elsewhere on the board

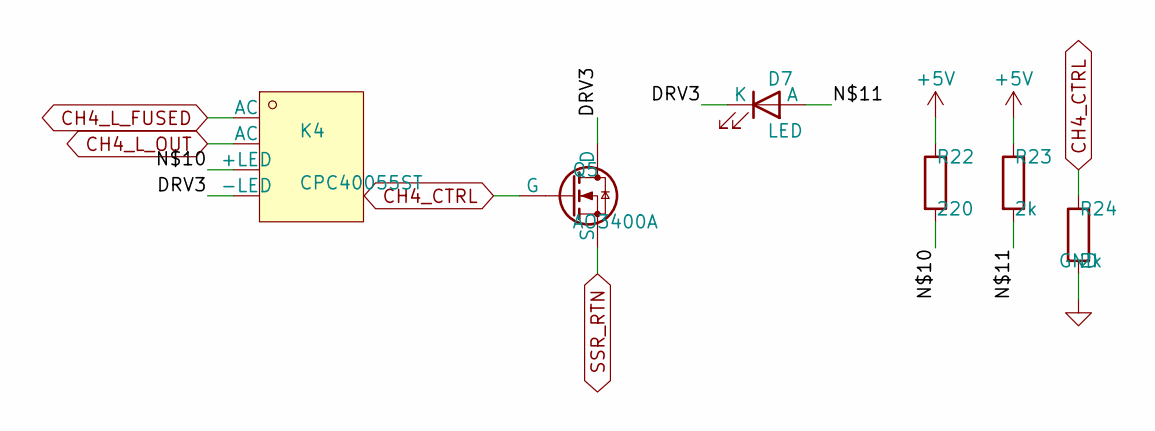
[picture p29: schematic circuit_ssr_channel4.kicad_sch, SKiDL-Generated Schematic - ssr_channel4]

Parts:
D7: LED; LED_0603_1608Metric; MPN 19-217/R6C-AL1M2VY/6T; LCSC C2986060
K4: CPC40055ST; SIP-4_L38.1-W3.8_CPC40055ST; MPN CPC40055ST; LCSC C1527353
Q5: AO3400A; SOT-23; MPN AO3400A; LCSC C20917
R22: 220; R_1206_3216Metric; MPN 1206W4F2200T5E; LCSC C17957
R23, R24: 2k; R_0402_1005Metric; MPN 0402WGF2001TCE; LCSC C4109

Connections:
+5V: R22.1, R23.1; also elsewhere on the board
/ssr_channel4/DRV3: D7.1 (K), K4.4 (-LED), Q5.3 (D)
/ssr_channel4/N$10: K4.3 (+LED), R22.2
/ssr_channel4/N$11: D7.2 (A), R23.2
CH4_CTRL: Q5.1 (G), R24.1; also elsewhere on the board
CH4_L_FUSED: K4.1 (AC); also elsewhere on the board
CH4_L_OUT: K4.2 (AC); also elsewhere on the board
GND: R24.2; also elsewhere on the board
SSR_RTN: Q5.2 (S); also elsewhere on the board

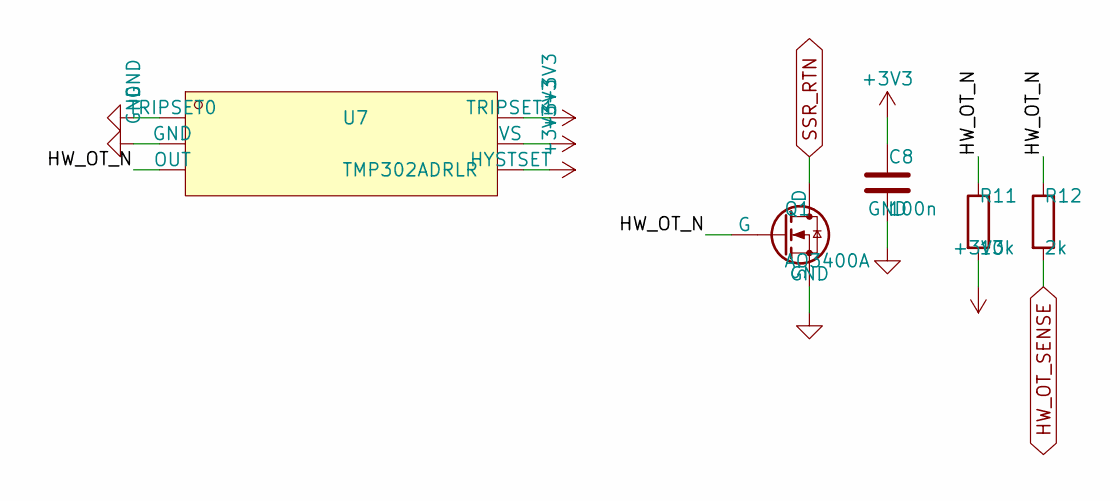
[picture p30: schematic circuit_thermal_cutoff1.kicad_sch, SKiDL-Generated Schematic - thermal_cutoff1]

Parts:
C8: 100n; C_0402_1005Metric; MPN CL05B104KO5NNNC; LCSC C1525
Q1: AO3400A; SOT-23; MPN AO3400A; LCSC C20917
R11: 10k; R_0402_1005Metric; MPN 0402WGF1002TCE; LCSC C25744
R12: 2k; R_0402_1005Metric; MPN 0402WGF2001TCE; LCSC C4109
U7: TMP302ADRLR; SOT-563_TI_DRL0006A; MPN TMP302ADRLR; LCSC C2877557

Connections:
+3V3: C8.1, R11.2, U7.4 (HYSTSET), U7.5 (VS), U7.6 (TRIPSET1); also elsewhere on the board
/thermal_cutoff1/HW_OT_N: Q1.1 (G), R11.1, R12.1, U7.3 (OUT)
GND: C8.2, Q1.2 (S), U7.1 (TRIPSET0), U7.2 (GND); also elsewhere on the board
HW_OT_SENSE: R12.2; also elsewhere on the board
SSR_RTN: Q1.3 (D); also elsewhere on the board

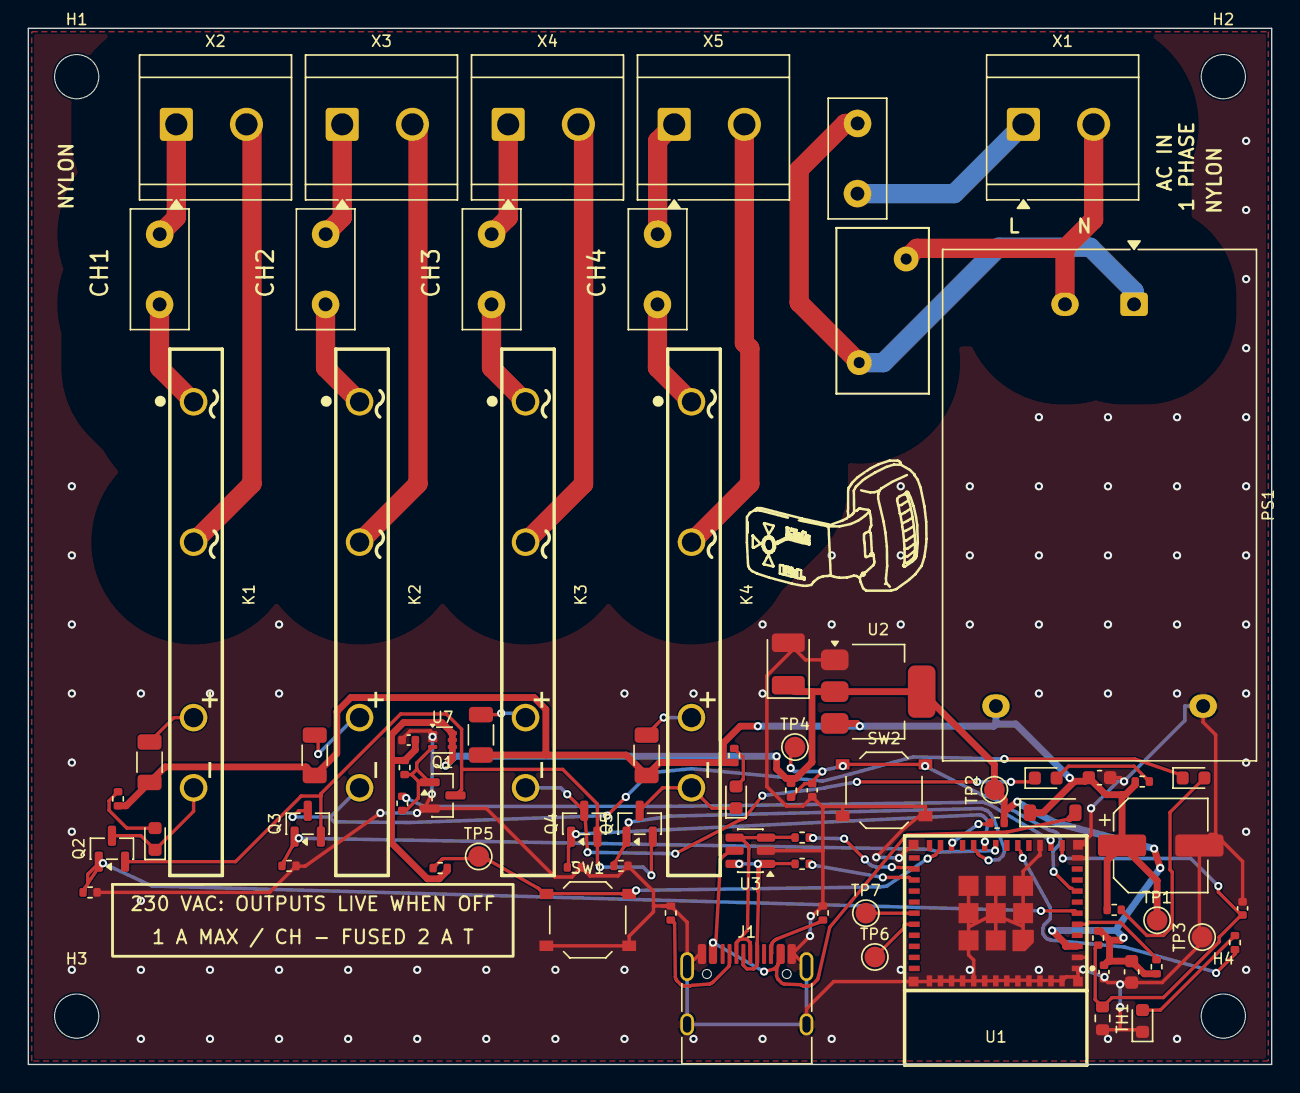
[picture p31: board circuit.kicad_pcb from above]

Board: 2 copper layers, 90.0 x 75.0 mm, 81 parts (0 on the bottom side), 53 nets.

Other parts of the board:
H1, H2, H3, H4: MountingHole; MountingHole_3.2mm_M3
