Bunty9/ssr4/(commit log)

2026-10-29 feat: publish the ssr4 board, rev A prototype
    Open-source four-channel 230 VAC solid-state switch for Home Assistant:
    ESP32-C3, ESPHome, zero-cross SSRs, a 60 C hardware over-temperature
    cutoff. KiCad 10 project and libraries, JLCPCB and PCBWay fabrication
    packages, circuit source, ESPHome firmware with tests on a PC simulation,
    validation evidence, guides from ordering to installation, and full
    resolution renders. Generated from pcb-factory commit 9c9d32b.
    [bom-sourced.csv, bom.csv, circuit.kicad_pcb, circuit.kicad_sch, circuit_mcu1.kicad_sch, circuit_power1.kicad_sch, circuit_ssr_channel1.kicad_sch, circuit_ssr_channel2.kicad_sch]
2026-10-29 fix(hardware): remove a ground via touching the antenna keep-out (#1)
    A GND stitching via overlapped the ESP32-C3 antenna keep-out by 0.02 mm;
    KiCad 10.0.7's DRC in CI flagged it. Regenerated board, fabrication
    packages and validation reports without it.
    [circuit.kicad_pcb]
2026-10-29 docs: heat-sink and enclosure hand-off with STEP files (#2)
    hardware/mechanical/ adds the STEP assembly (manufacturers' models placed
    where the checked 3D view has them), a board-only STEP and the outline DXF,
    origin at the board's lower-left corner. docs/mechanical.md is the design
    hand-off measured from that assembly: envelope, SSR thermal faces, heat
    sink concepts and safety rules, enclosure openings, mounting and material.
    [ssr4-assembly.step, ssr4-board-only.step, ssr4-outline.dxf]
