Bunty9/ssr4/(notices)

Notices in the files:
README.md:
Docs: CC BY-SA 4.0
parts and their libraries:
Silkscreen doodle: scouter line art, 13.0 x 9.5 mm, silkscreen only, no copper. Traced from fan art of the Dragon Ball Z scouter (camarinox, DeviantArt); Dragon Ball is (c) Bird Studio/Shueisha, Toei Animation. Personal decoration: not covered by this repo hardware licence.
